2AMLogic/sg13g2-sram/sim/column/README.md

# sim/column

Nominal functional bench of the I/O column (`design/column/`): read of 0 and 1,
write of 0 and 1, at mos_tt, 1.20 V, 27 °C only. The corner grid, Monte Carlo,
access time and array-level margins are #26.

- `bench_read.cir`, `bench_write.cir`: two column copies each (real `bitcell`
  netlist, 127 unselected rows per bit line present, the half-selected cell of
  the unselected mux column present). Timelines are in the file headers.
- `column_post.py`: generates the `klt sim` requests, evaluates the
  measurements into per-case verdicts, builds the negative-control benches.
  `test_column_post.py` tests it without a simulator.
- `run_column.sh`: freshness check of the netlists, both benches, two negative
  controls (write-driver stacks at 0.15 µm; sense enable fired with the
  wordline), then `records/<UTC>/` (append-only).

Checks per case (limits are this bench's functional criteria, not spec values):
`OUT` resolves the stored value (|OUT−OUTB| > 1.0 V); bit-line differential at
the sense instant has the right sign; bit lines precharged (> 1.15 V) and
equalized (< 20 mV) before the wordline; selected and half-selected cells keep
their value; the unselected column's bit lines stay above 0.6 V. Write: flipped
at the end of the 1 ns pulse, flip time (from the 50 % point of the WL edge)
under 1 ns, value holds at 2.8 ns.

## Status

Latest record: `records/20261027T234939Z/` (nominal, mos_tt / 1.20 V / 27 C; batch
job `klt-sim-101d18689c47`, runner klt 0.8.0, ngspice 46). `all_pass` is **true**.
The benches now include only `design/column/column.spice`, which embeds the bitcell and
periphery subckts; before, each subckt was defined twice. Read and write verdicts match
the previous record `records/20261027T220739Z/` (same flip-time range, same detections).
The column has per-pair precharge enables (`PRE0_B`, `PRE1_B`); the benches hold the
unselected pair's enable low (precharged) through the wordline pulse.

- Read of 0 and of 1: the sense amp resolves the stored value, the bit-line
  differential has the right sign, precharge and equalize complete, both cells
  keep their value.
- Write of 0 and of 1: the cell flips 0.06-0.09 ns after the wordline midpoint
  (limit 1 ns) and the value holds at 2.8 ns.
- Unselected column: bit lines stay at or above 1.118 V (limit 0.6 V, unchanged).
- Negative controls: the 0.15 um write driver and the SAE-with-wordline read are
  both detected.

Earlier record `records/20261027T211740Z/` (shared `PRE_B`, `all_pass` false:
the floating unselected pair fell to about 0.07 V) is kept unchanged as evidence.
The write-driver sizing justification is in `design/column/README.md` (sweep below).

## Write-driver width sweep

`run_sizing.sh [width_um ...]` writes one write bench per driver-stack width
(default 0.15 0.3 0.5 1.0 2.0 3.0 um, mos_tt / 1.20 V / 27 C) and submits them as one
`klt sim --batch-set` (batch only, no local fallback, `--capacity-retries 4`). It leaves the
reports under `sizing/<UTC>/` (append-only); summarise with
`python3 -I column_post.py sizing <label> <width_um>=<report> ...`, which gives the flip
time per width and the smallest passing width; `run_sizing.sh` does this itself and writes
`summary.json`. **Run** on 2026-10-28 (`sizing/20261028T074902Z/`, six batch jobs, runner
klt 0.8.0): flip time at 0.15 / 0.3 / 0.5 / 1.0 / 2.0 / 3.0 µm is no flip / 0.96 (fails the
1 ns check) / 0.54 / 0.25 / 0.12 / 0.09 ns (worst of the two written values); smallest
passing width 0.5 µm. The per-width reports were fetched by re-attaching to the batch jobs
(`--attach`) because the first version of the script deleted its scratch dir; the script now
keeps them.

A klt batch run whose corner errors exits 4; `run_column.sh` accepts that only for
the two negative controls (a driver that never flips the cell leaves the flip
time without a value, which is the detection) and only if the report exists.
