2AMLogic/sg13g2-sram/spec/porting-plan.md

# Porting plan: `gf180-sram` to SG13G2

**Status**: Proposed, 2026-10-17 (not self-ratified)
**Origin read**: `2AMLogic/gf180-sram` @ `d0bacc0fceb6e9400e54e3efe15ec1630711faa9`
(local checkout `~/GitHub/gf180-sram`, `main` HEAD on 2026-10-17)

`gf180-sram` is master for the spec structure, margin definitions,
statistical treatment and harness. This table lists every item as
**inherited** (taken unchanged, with the origin file) or **re-derived**
(device-level, with the reason). Departures from the origin are decision
records in this directory.

## Inherited

| Item | Origin file @ `d0bacc0` | Here |
|---|---|---|
| Organization: fixed 256 × 32 (1 kB) first; generator is a stretch | `spec/sram.md` § Organization | `spec/sram.md` |
| Ports: 1RW target, 1RW1R stretch | `spec/sram.md` § Ports | `spec/sram.md` |
| Deliverables: GDS, LEF, Liberty generated by this repo's own flow | `spec/sram.md` § Deliverables | `spec/sram.md` |
| Block kind: `analog` (scoped to custom bitcell/array and PVT characterization) | `spec/block-kind-decision.md` | `spec/sram.md` |
| Margin definitions: read SNM, hold SNM, write margin; access time recorded per corner | `spec/sram.md` § Characterization | `spec/sram.md` |
| Pass rule: SNMs and write margin strictly positive at every corner | `spec/sram.md` § Signoff definition | `spec/sram.md` |
| Statistical treatment: the three margins are Monte Carlo rows, combined with (never replacing) the corner matrix; seed, sample count, deterministic negative control, `klt yield` report | `spec/statistical-treatment-decision.md` | `spec/sram.md` |
| Grading: Cpk, sigma-to-spec and the exact empirical-yield lower bound; no numeric `target_yield` | `spec/target-yield-decision.md` | `spec/sram.md` |
| Write margin measured against a fixed, stated pulse width; no independent macro timing target | `spec/write-pulse-width-decision.md` (rule only; the value is re-derived) | `spec/write-pulse-width-decision.md` |
| Corner count stated as arithmetic with the product written out | `spec/corner-count-correction.md` | `spec/sram.md` |
| Sim harness (corner sweep, MC campaign, SNM extraction) | `sim/lib/` (`run_corner_sweep.sh`, `run_mc_campaign.py`, `snm_extract.py`, `pdk_env.sh`) | by pinned reference, see #4; `mint_sim_envelope.py` and `render_signoff_table.py` not ported, see `spec/signoff-tooling-decision.md`; `env_provenance.py` not vendored, see `spec/env-provenance-departure-decision.md` |
| Append-only `sim/` evidence | `CLAUDE.md` | `CLAUDE.md` |

The harness is not vendored by this issue. The pinned-reference mechanism
(`reuse.lock.json`, `REUSE.md` in `2AMLogic/2am`) belongs to #4. Neither file
exists in this repo yet, so the harness row above names the origin paths only.

## Re-derived

| Item | Why it cannot be inherited | Where |
|---|---|---|
| Bitcell: topology and sizing | Different devices (`sg13_lv_nmos` / `sg13_lv_pmos`, 130 nm, 1.2 V) and a different answer to the first question | `spec/bitcell-decision.md` |
| Supply: 1.2 V ±10% (1.08 / 1.20 / 1.32 V) | Origin is 3.3 V; SG13G2 core devices are 1.2 V | `spec/sram.md` |
| Rail sharing (array vs periphery) | Shipped macros separate `VDD` from `VDDARRAY`; the origin has one rail | `spec/sram.md`, open |
| PVT corners: `mos_tt/ss/ff/sf/fs` × −40/25/125 °C × 3 supplies = 45 | Origin used `ff/tt/ss` only (27). SG13G2 ships skew corners | `spec/sram.md` |
| Write-pulse width value | Origin's 2 ns was a testbench window tied to a 180 nm, 3.3 V cell; the number does not transfer | `spec/write-pulse-width-decision.md` |
| Reference row (area, timing) | Different comparison part (`RM_IHPSG13_1P_256x32_c2_bm_bist`) | `spec/sram.md` |
| Deck acceptance | Different deck (klt SG13G2, newer) | `spec/sram.md` |
| PDK pin and OSDI model loading | Origin pinned `gf180mcuD`; SG13G2 compact models load through OSDI | #5, not this issue |

## Open questions from the issue

| Question | Status | Owner |
|---|---|---|
| Does klt's SG13G2 LVS extract a dense 6T array correctly at full size? | **Open, verify at first run.** No array exists yet; nothing is assumed. | bitcell and array layout issues; friction goes to `2AMLogic/klayout-tools` |
| Does the origin harness run unchanged on OSDI-loaded models? | **Open, verify at first run.** Likely divergences to watch: `.lib` section names (`mos_tt` etc. in `cornerMOSlv.lib`), OSDI module loading in `ngspice`, Monte Carlo parameter names. Any divergence gets recorded, not hidden. | #5 (PDK/OSDI pin and smoke sim), #4 (harness reuse) |
| Should the 1RW pin interface differ? | **No.** Answered in `spec/sram.md` § Ports: keep the origin's interface; the shipped macro's differs (bit mask, BIST, `A_DLY`) and is a comparison, not a template. | this issue |

## Checks run for this document

- Every origin path above exists at the pinned commit
  (`git -C ~/GitHub/gf180-sram cat-file -e d0bacc0:<path>`), run
  2026-10-17.
- `sim/lib/` filenames were read from the origin checkout's working tree at
  the same commit.
