2AMLogic/sg13g2-sram/WORK_PLAN.md

# Work Plan

Roadmap generated by the Guide triage agent from current GitHub label state.
Only the region between the markers is machine-generated.

<!-- guide:plan-body:start -->
## Operator Attention: Merge-Risk-Hold Pileup

Judge-approved PRs under a hold (`loom:blocked` or `loom:operator`) — only a human merge decision is missing.

_None._

## Very Important

`loom:very-important` (one counts per workspace); every stage takes these first.

- **#105**: layout: route decoder cell internals

## Important

`loom:important`; taken before unlabelled work.

- **#88**: Macro layout: route periphery, array-to-column-path and pins so the macro is extractable
- **#105**: layout: route decoder cell internals
- **#107**: layout: route global control fan-out and per-slice DL/DOUT
- **#108**: layout: connect macro pins, signals record, verify and README

## Ready

Human-approved issues ready for implementation (`loom:issue`).

_None._

## In Progress

Issues currently being built (`loom:building`).

- **#37**: Post-hoc two-key ratification review of spec/sram.md as merged in #7
- **#56**: Consolidate duplicated helpers across sim/*_post.py into one shared module
- **#69**: spec: confirm the 1 ns write-pulse window
- **#71**: spec: write-margin definition under-specified
- **#72**: spec: internal inconsistencies in sram.md text
- **#74**: spec: no area target, min-clock-pulse, power or retention rows
- **#105**: layout: route decoder cell internals
- **#126**: netlist: scalar WEN vs the origin's per-bit WEN[31:0]; Views row ratified by #79 assumes the per-bit interface

## PRs Awaiting Review

PRs waiting on Judge (`loom:review-requested`).

- **#77**: docs(spec): record two-key review outcome for sram.md
- **#78**: docs: make spec/sram.md internally consistent on corners, signoff, open items, typical point
- **#80**: docs: add decision record for area, min-clock-pulse, power and retention spec rows
- **#81**: docs(spec): pin the write-margin definition in a decision record

## Approved (Awaiting Merge)

PRs that passed review and are queued for Champion auto-merge (`loom:pr`).

_None._

## Proposed

Issues carrying `loom:curated`.

- **#30**: T1 item 4 (LVS clean): klt lvs of the full macro vs the item-1 netlist *(curated)*
- **#37**: Post-hoc two-key ratification review of spec/sram.md as merged in #7 *(curated)*
- **#68**: spec: margins row has no Monte Carlo evidence *(curated)*
- **#69**: spec: confirm the 1 ns write-pulse window *(curated)*
- **#71**: spec: write-margin definition under-specified *(curated)*
- **#72**: spec: internal inconsistencies in sram.md text *(curated)*
- **#74**: spec: no area target, min-clock-pulse, power or retention rows *(curated)*
- **#88**: Macro layout: route periphery, array-to-column-path and pins so the macro is extractable *(curated)*
- **#105**: layout: route decoder cell internals *(curated)*
- **#107**: layout: route global control fan-out and per-slice DL/DOUT *(curated)*
- **#126**: netlist: scalar WEN vs the origin's per-bit WEN[31:0]; Views row ratified by #79 assumes the per-bit interface *(curated)*

## Proposed (Architect / Hermit)

- **#56**: Consolidate duplicated helpers across sim/*_post.py into one shared module *(hermit)*
- **#117**: Remove superseded macro-record scripts generate-macro-routed.sh and generate-macro-rails.sh *(hermit)*

## Epics

_None._

## Backlog Balance

| Bucket | Count |
|---|---|
| Operator merge-risk holds | 0 |
| Very important | 1 |
| Important | 4 |
| Ready (`loom:issue`) | 0 |
| In Progress (`loom:building`) | 8 |
| PRs awaiting review | 4 |
| Approved PRs awaiting merge | 0 |
| Curated | 11 |
| Architect / Hermit proposals | 2 |
| Active epics | 0 |
<!-- guide:plan-body:end -->
