2AMLogic/sg13g2-sram/ratification/ee-key/MANIFEST.md

# MANIFEST — ee-key

Adapted 2026-10-27 from `2AMLogic/gf180-gate-driver` `ratification/ee-key/`. The rubric gains an SRAM-macro section; the sibling-precedent list in `SKILL.md` Step 3 names the SRAM siblings. Nothing else differs from the template.

## Skill files

- `SKILL.md`
- `rubric.md`

Installed at `ratification/ee-key/`.
