2AMLogic/sg13g2-sram/ratification/market-key/MANIFEST.md

# MANIFEST — market-key

Adapted 2026-10-27 from `2AMLogic/gf180-gate-driver` `ratification/market-key/`. The gate-driver comp data is replaced by `comps/sram.md`; `comp-table-format.md` loses one repo-specific numbering example. `SKILL.md` and `rubric.md` are unchanged from the template.

## Skill files

- `SKILL.md`
- `comp-table-format.md`
- `rubric.md`

## Comp data

- `comps/sram.md`
