2AMLogic/sg13g2-sram/ratification/ee-key/rubric.md

# Verdict rubric

Three tokens, applied per row (`SKILL.md` Step 4) and rolled up to one
overall `approve`/`request-changes` verdict (`SKILL.md`'s "Output format").

Deliberately self-contained: nothing below names, numbers, or references
this repo's own internal fleet-operations detail — only device physics, the target
repo's own cited evidence, and `klayout-tools`' public
`docs/design-evidence-tiers.md`.

## `sound`

The row's claim is independently re-derivable from cited design sources
(schematic, netlist, sizing table) and/or backed by `sim/` evidence that
passes the relevant `design-evidence-tiers.md` T1 items for that row
(provenance-fresh, corner coverage matching the claim, Monte Carlo present
if the row is statistical). A row whose value is a **mechanical consequence**
of an already-ratified row plus the merged design's own structure — with no
new measurement needed — is also `sound`, provided the derivation is
actually checked against the source rather than merely asserted.

## `insufficient-evidence`

The row's value is not physically implausible, but the evidence backing it
falls short of what `design-evidence-tiers.md`'s T1 checklist requires for
the claim being made — an "informal, uncommitted" sanity check the design
doc itself disclaims as non-evidentiary, a single-corner/single-temperature
check standing in for a PVT claim, a plumbing-only `sim/` record (the DUT
never completed simulation) standing in for a design measurement, or a
statistical row backed only by a deterministic corner sweep. This is not a
verdict that the value is wrong — it is a statement that this key cannot
certify it as `sound` on the evidence actually on record, and the row should
stay unratified (or be flagged) until the gap closes.

## `unsound`

The row's claim contradicts what the cited design source, PDK physics, or
existing `sim/` evidence actually shows — a re-derivation that does not
match the PR's stated conclusion, a claim that ignores a device limit or
corner-dependent effect the block's own topology is known to be sensitive
to, or a row ratified on the back of evidence that itself failed (see the
relax-after-measured-FAIL check, `SKILL.md` Step 5) without an independent
physical justification for why the weaker value still holds. Absence of any
evidence at all for a claim with no plausible mechanical derivation is
`unsound` by default, the same way the market key's own rubric treats an
uncited value as `uncompetitive` by default rather than extending it the
benefit of the doubt.

## SRAM-macro rows: what `sound` has to cover

Applied on top of the three tokens above when the spec is an SRAM macro:

- **Bitcell margin rows (read SNM, hold SNM, write margin)** are mismatch-
  driven. `sound` needs the corner matrix **and** Monte Carlo evidence
  (recorded seed, sample count, deterministic negative control); a corner
  sweep alone is `insufficient-evidence`, per the statistical-row clause
  above. Skew corners matter because read stability and write margin move in
  opposite directions across the skew.
- **Supply and corner rows** must match the models actually loaded for the
  device class (core-voltage devices only, the corner file the rows cite).
- **Access time and write completion** are recorded values, not pass
  thresholds, unless the spec ratifies a number; a row that states a
  threshold with no measurement is `unsound` by default.
- **Array/periphery rows** (organization, ports, pin interface) are
  mechanical consequences of the cited organization where they are
  derivations; check the arithmetic against the cited source.
- **Open items the spec itself lists** (for example rail sharing) are not
  rows to be ratified; confirm each is marked open with an owner, and that no
  row silently depends on its outcome.
- **Deck acceptance** statements (DRC/LVS "clean" definitions) are checked
  for what they claim: a definition that has not yet been run is fine
  if it says so, and is `unsound` if it presents an unrun check as done.

## The EE-key / market-key jurisdiction boundary

This key reviews **every** row a ratification PR proposes for technical
soundness — unlike the market key, there is no row-classification split
into "in scope"/"out of scope" here, because every spec row makes a physical
engineering claim whether or not a buyer could observe it externally. What
this key does **not** do is rule on whether a technically sound value is
*competitive* — a row can be `sound` (physically well-derived, adequately
evidenced) and still be weak against the market, or `unsound` and still
happen to beat every public comp; the two questions are independent by
design.
Scoring competitiveness,
favorably or unfavorably, is itself a rubric violation for this key — it
lets the EE key exercise judgment over ground the two-key design reserves
for the market key, defeating the incentive-separation the mechanism exists
to protect.
