2AMLogic/sg13g2-sram/design/column/column.spice

** sch_path: design/column/column.sch

* one I/O column, mux 2: two bit-line pairs of 128 cells (7 row + 1 column address bits).


* WL = the selected row (both pairs), WLU = the other 127 rows (shared net, held low).


* XU cells of a pair share one Q/QB node pair UQ/UQB: 127 identical cells, same state.

.subckt column PRE0_B PRE1_B SEL0 SEL0B SEL1 SEL1B SAE WE DIN WL WLU DOUT DOUTB VDD VSS
*.ipin PRE0_B
*.ipin PRE1_B
*.ipin SEL0
*.ipin SEL0B
*.ipin SEL1
*.ipin SEL1B
*.ipin SAE
*.ipin WE
*.ipin DIN
*.ipin WL
*.ipin WLU
*.iopin DOUT
*.iopin DOUTB
*.iopin VDD
*.iopin VSS
XC0 BL0 BLB0 WL VDD VSS Q0 QB0 bitcell
XC1 BL1 BLB1 WL VDD VSS Q1 QB1 bitcell
XU0[126] BL0 BLB0 WLU VDD VSS UQ0 UQB0 bitcell
XU0[125] BL0 BLB0 WLU VDD VSS UQ0 UQB0 bitcell
XU0[124] BL0 BLB0 WLU VDD VSS UQ0 UQB0 bitcell
XU0[123] BL0 BLB0 WLU VDD VSS UQ0 UQB0 bitcell
XU0[122] BL0 BLB0 WLU VDD VSS UQ0 UQB0 bitcell
XU0[121] BL0 BLB0 WLU VDD VSS UQ0 UQB0 bitcell
XU0[120] BL0 BLB0 WLU VDD VSS UQ0 UQB0 bitcell
XU0[119] BL0 BLB0 WLU VDD VSS UQ0 UQB0 bitcell
XU0[118] BL0 BLB0 WLU VDD VSS UQ0 UQB0 bitcell
XU0[117] BL0 BLB0 WLU VDD VSS UQ0 UQB0 bitcell
XU0[116] BL0 BLB0 WLU VDD VSS UQ0 UQB0 bitcell
XU0[115] BL0 BLB0 WLU VDD VSS UQ0 UQB0 bitcell
XU0[114] BL0 BLB0 WLU VDD VSS UQ0 UQB0 bitcell
XU0[113] BL0 BLB0 WLU VDD VSS UQ0 UQB0 bitcell
XU0[112] BL0 BLB0 WLU VDD VSS UQ0 UQB0 bitcell
XU0[111] BL0 BLB0 WLU VDD VSS UQ0 UQB0 bitcell
XU0[110] BL0 BLB0 WLU VDD VSS UQ0 UQB0 bitcell
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
XU1[15] BL1 BLB1 WLU VDD VSS UQ1 UQB1 bitcell
XU1[14] BL1 BLB1 WLU VDD VSS UQ1 UQB1 bitcell
XU1[13] BL1 BLB1 WLU VDD VSS UQ1 UQB1 bitcell
XU1[12] BL1 BLB1 WLU VDD VSS UQ1 UQB1 bitcell
XU1[11] BL1 BLB1 WLU VDD VSS UQ1 UQB1 bitcell
XU1[10] BL1 BLB1 WLU VDD VSS UQ1 UQB1 bitcell
XU1[9] BL1 BLB1 WLU VDD VSS UQ1 UQB1 bitcell
XU1[8] BL1 BLB1 WLU VDD VSS UQ1 UQB1 bitcell
XU1[7] BL1 BLB1 WLU VDD VSS UQ1 UQB1 bitcell
XU1[6] BL1 BLB1 WLU VDD VSS UQ1 UQB1 bitcell
XU1[5] BL1 BLB1 WLU VDD VSS UQ1 UQB1 bitcell
XU1[4] BL1 BLB1 WLU VDD VSS UQ1 UQB1 bitcell
XU1[3] BL1 BLB1 WLU VDD VSS UQ1 UQB1 bitcell
XU1[2] BL1 BLB1 WLU VDD VSS UQ1 UQB1 bitcell
XU1[1] BL1 BLB1 WLU VDD VSS UQ1 UQB1 bitcell
XU1[0] BL1 BLB1 WLU VDD VSS UQ1 UQB1 bitcell
XPC0 PRE0_B BL0 BLB0 VDD VSS precharge
XPC1 PRE1_B BL1 BLB1 VDD VSS precharge
XMUX SEL0 SEL0B SEL1 SEL1B BL0 BLB0 BL1 BLB1 BLM BLBM VDD VSS column_mux
XSA SAE BLM BLBM DOUT DOUTB VDD VSS sense_amp
XWD WE DIN BLM BLBM VDD VSS write_driver
.ends

* expanding   symbol:  ../bitcell/bitcell.sym # of pins=7
** sym_path: design/bitcell/bitcell.sym
** sch_path: design/bitcell/bitcell.sch
.subckt bitcell BL BLB WL VDD VSS Q QB
*.iopin BL
*.iopin BLB
*.ipin WL
*.iopin VDD
*.iopin VSS
*.iopin Q
*.iopin QB
XMP0 Q QB VDD VDD sg13_lv_pmos w=0.15u l=0.13u ng=1 m=1
XMN0 Q QB VSS VSS sg13_lv_nmos w=0.30u l=0.13u ng=1 m=1
XMP1 QB Q VDD VDD sg13_lv_pmos w=0.15u l=0.13u ng=1 m=1
XMN1 QB Q VSS VSS sg13_lv_nmos w=0.30u l=0.13u ng=1 m=1
XMN2 BL WL Q VSS sg13_lv_nmos w=0.30u l=0.13u ng=1 m=1
XMN3 BLB WL QB VSS sg13_lv_nmos w=0.30u l=0.13u ng=1 m=1
**** begin user architecture code

* 6T SRAM bitcell, reference sizing from spec/bitcell-decision.md evidence 1

**** end user architecture code
.ends


* expanding   symbol:  precharge.sym # of pins=5
** sym_path: design/column/precharge.sym
** sch_path: design/column/precharge.sch
.subckt precharge PRE_B BL BLB VDD VSS
*.ipin PRE_B
*.iopin BL
*.iopin BLB
*.iopin VDD
*.iopin VSS
XMP0 BL PRE_B VDD VDD sg13_lv_pmos w=1.0u l=0.13u ng=1 m=1
XMP1 BLB PRE_B VDD VDD sg13_lv_pmos w=1.0u l=0.13u ng=1 m=1
XMP2 BL PRE_B BLB VDD sg13_lv_pmos w=1.0u l=0.13u ng=1 m=1
**** begin user architecture code

* bit-line precharge to VDD and equalize, active-low PRE_B

**** end user architecture code
.ends


* expanding   symbol:  column_mux.sym # of pins=12
** sym_path: design/column/column_mux.sym
** sch_path: design/column/column_mux.sch
.subckt column_mux SEL0 SEL0B SEL1 SEL1B BL0 BLB0 BL1 BLB1 BLM BLBM VDD VSS
*.ipin SEL0
*.ipin SEL0B
*.ipin SEL1
*.ipin SEL1B
*.iopin BL0
*.iopin BLB0
*.iopin BL1
*.iopin BLB1
*.iopin BLM
*.iopin BLBM
*.iopin VDD
*.iopin VSS
XMN0T BL0 SEL0 BLM VSS sg13_lv_nmos w=2.0u l=0.13u ng=1 m=1
XMP0T BL0 SEL0B BLM VDD sg13_lv_pmos w=2.0u l=0.13u ng=1 m=1
XMN0B BLB0 SEL0 BLBM VSS sg13_lv_nmos w=2.0u l=0.13u ng=1 m=1
XMP0B BLB0 SEL0B BLBM VDD sg13_lv_pmos w=2.0u l=0.13u ng=1 m=1
XMN1T BL1 SEL1 BLM VSS sg13_lv_nmos w=2.0u l=0.13u ng=1 m=1
XMP1T BL1 SEL1B BLM VDD sg13_lv_pmos w=2.0u l=0.13u ng=1 m=1
XMN1B BLB1 SEL1 BLBM VSS sg13_lv_nmos w=2.0u l=0.13u ng=1 m=1
XMP1B BLB1 SEL1B BLBM VDD sg13_lv_pmos w=2.0u l=0.13u ng=1 m=1
**** begin user architecture code

* 2:1 column mux: NMOS+PMOS transmission gates, SELn high / SELnB low selects column n

**** end user architecture code
.ends


* expanding   symbol:  sense_amp.sym # of pins=7
** sym_path: design/column/sense_amp.sym
** sch_path: design/column/sense_amp.sch
.subckt sense_amp SAE BLM BLBM OUT OUTB VDD VSS
*.ipin SAE
*.iopin BLM
*.iopin BLBM
*.iopin OUT
*.iopin OUTB
*.iopin VDD
*.iopin VSS
XMPI0 OUT SAE BLM VDD sg13_lv_pmos w=2.0u l=0.13u ng=1 m=1
XMPI1 OUTB SAE BLBM VDD sg13_lv_pmos w=2.0u l=0.13u ng=1 m=1
XMPL0 OUT OUTB VDD VDD sg13_lv_pmos w=1.0u l=0.13u ng=1 m=1
XMPL1 OUTB OUT VDD VDD sg13_lv_pmos w=1.0u l=0.13u ng=1 m=1
XMNL0 OUT OUTB TAIL VSS sg13_lv_nmos w=1.0u l=0.13u ng=1 m=1
XMNL1 OUTB OUT TAIL VSS sg13_lv_nmos w=1.0u l=0.13u ng=1 m=1
XMNT TAIL SAE VSS VSS sg13_lv_nmos w=2.0u l=0.13u ng=1 m=1
**** begin user architecture code

* latch SA: SAE low = isolation PMOS pass bit lines to OUT/OUTB, SAE high = latch

**** end user architecture code
.ends


* expanding   symbol:  write_driver.sym # of pins=6
** sym_path: design/column/write_driver.sym
** sch_path: design/column/write_driver.sch
.subckt write_driver WE DIN BLM BLBM VDD VSS
*.ipin WE
*.ipin DIN
*.iopin BLM
*.iopin BLBM
*.iopin VDD
*.iopin VSS
XMPD DINB DIN VDD VDD sg13_lv_pmos w=0.5u l=0.13u ng=1 m=1
XMND DINB DIN VSS VSS sg13_lv_nmos w=0.5u l=0.13u ng=1 m=1
XMNA0 BLM DINB WA VSS sg13_lv_nmos w=3.0u l=0.13u ng=1 m=1
XMNA1 WA WE VSS VSS sg13_lv_nmos w=3.0u l=0.13u ng=1 m=1
XMNB0 BLBM DIN WB VSS sg13_lv_nmos w=3.0u l=0.13u ng=1 m=1
XMNB1 WB WE VSS VSS sg13_lv_nmos w=3.0u l=0.13u ng=1 m=1
**** begin user architecture code

* write driver: WE and DIN pull BLBM low, WE and DINB pull BLM low (cell Q takes DIN)

**** end user architecture code
.ends
