2AMLogic/sg13g2-sram/design/decoder/row_decoder.spice

** sch_path: design/decoder/row_decoder.sch

* 7-bit row decoder: A[2:0] -> X (8), A[6:3] -> Y (16), WL[8*j+k] = X[k] & Y[j] & WLEN

.subckt row_decoder A[6] A[5] A[4] A[3] A[2] A[1] A[0] WLEN WL[127] WL[126] WL[125] WL[124] WL[123] WL[122] WL[121] WL[120]
+ WL[119] WL[118] WL[117] WL[116] WL[115] WL[114] WL[113] WL[112] WL[111] WL[110] WL[109] WL[108] WL[107] WL[106] WL[105] WL[104] WL[103]
+ WL[102] WL[101] WL[100] WL[99] WL[98] WL[97] WL[96] WL[95] WL[94] WL[93] WL[92] WL[91] WL[90] WL[89] WL[88] WL[87] WL[86] WL[85] WL[84]
+ WL[83] WL[82] WL[81] WL[80] WL[79] WL[78] WL[77] WL[76] WL[75] WL[74] WL[73] WL[72] WL[71] WL[70] WL[69] WL[68] WL[67] WL[66] WL[65]
+ WL[64] WL[63] WL[62] WL[61] WL[60] WL[59] WL[58] WL[57] WL[56] WL[55] WL[54] WL[53] WL[52] WL[51] WL[50] WL[49] WL[48] WL[47] WL[46]
+ WL[45] WL[44] WL[43] WL[42] WL[41] WL[40] WL[39] WL[38] WL[37] WL[36] WL[35] WL[34] WL[33] WL[32] WL[31] WL[30] WL[29] WL[28] WL[27]
+ WL[26] WL[25] WL[24] WL[23] WL[22] WL[21] WL[20] WL[19] WL[18] WL[17] WL[16] WL[15] WL[14] WL[13] WL[12] WL[11] WL[10] WL[9] WL[8] WL[7]
+ WL[6] WL[5] WL[4] WL[3] WL[2] WL[1] WL[0] VDD VSS
*.ipin A[6]
*.ipin A[5]
*.ipin A[4]
*.ipin A[3]
*.ipin A[2]
*.ipin A[1]
*.ipin A[0]
*.ipin WLEN
*.opin WL[127]
*.opin WL[126]
*.opin WL[125]
*.opin WL[124]
*.opin WL[123]
*.opin WL[122]
*.opin WL[121]
*.opin WL[120]
*.opin WL[119]
*.opin WL[118]
*.opin WL[117]
*.opin WL[116]
*.opin WL[115]
*.opin WL[114]
*.opin WL[113]
*.opin WL[112]
*.opin WL[111]
*.opin WL[110]
*.opin WL[109]
*.opin WL[108]
*.opin WL[107]
*.opin WL[106]
*.opin WL[105]
*.opin WL[104]
*.opin WL[103]
*.opin WL[102]
*.opin WL[101]
*.opin WL[100]
*.opin WL[99]
*.opin WL[98]
*.opin WL[97]
*.opin WL[96]
*.opin WL[95]
*.opin WL[94]
*.opin WL[93]
*.opin WL[92]
*.opin WL[91]
*.opin WL[90]
*.opin WL[89]
*.opin WL[88]
*.opin WL[87]
*.opin WL[86]
*.opin WL[85]
*.opin WL[84]
*.opin WL[83]
*.opin WL[82]
*.opin WL[81]
*.opin WL[80]
*.opin WL[79]
*.opin WL[78]
*.opin WL[77]
*.opin WL[76]
*.opin WL[75]
*.opin WL[74]
*.opin WL[73]
*.opin WL[72]
*.opin WL[71]
*.opin WL[70]
*.opin WL[69]
*.opin WL[68]
*.opin WL[67]
*.opin WL[66]
*.opin WL[65]
*.opin WL[64]
*.opin WL[63]
*.opin WL[62]
*.opin WL[61]
*.opin WL[60]
*.opin WL[59]
*.opin WL[58]
*.opin WL[57]
*.opin WL[56]
*.opin WL[55]
*.opin WL[54]
*.opin WL[53]
*.opin WL[52]
*.opin WL[51]
*.opin WL[50]
*.opin WL[49]
*.opin WL[48]
*.opin WL[47]
*.opin WL[46]
*.opin WL[45]
*.opin WL[44]
*.opin WL[43]
*.opin WL[42]
*.opin WL[41]
*.opin WL[40]
*.opin WL[39]
*.opin WL[38]
*.opin WL[37]
*.opin WL[36]
*.opin WL[35]
*.opin WL[34]
*.opin WL[33]
*.opin WL[32]
*.opin WL[31]
*.opin WL[30]
*.opin WL[29]
*.opin WL[28]
*.opin WL[27]
*.opin WL[26]
*.opin WL[25]
*.opin WL[24]
*.opin WL[23]
*.opin WL[22]
*.opin WL[21]
*.opin WL[20]
*.opin WL[19]
*.opin WL[18]
*.opin WL[17]
*.opin WL[16]
*.opin WL[15]
*.opin WL[14]
*.opin WL[13]
*.opin WL[12]
*.opin WL[11]
*.opin WL[10]
*.opin WL[9]
*.opin WL[8]
*.opin WL[7]
*.opin WL[6]
*.opin WL[5]
*.opin WL[4]
*.opin WL[3]
*.opin WL[2]
*.opin WL[1]
*.opin WL[0]
*.iopin VDD
*.iopin VSS
XP3 A[2] A[1] A[0] X[7] X[6] X[5] X[4] X[3] X[2] X[1] X[0] VDD VSS predec3
XP4 A[6] A[5] A[4] A[3] Y[15] Y[14] Y[13] Y[12] Y[11] Y[10] Y[9] Y[8] Y[7] Y[6] Y[5] Y[4] Y[3] Y[2] Y[1] Y[0] VDD VSS predec4
XWD X[7] X[6] X[5] X[4] X[3] X[2] X[1] X[0] Y[15] Y[14] Y[13] Y[12] Y[11] Y[10] Y[9] Y[8] Y[7] Y[6] Y[5] Y[4] Y[3] Y[2] Y[1] Y[0]
+ WLEN WL[127] WL[126] WL[125] WL[124] WL[123] WL[122] WL[121] WL[120] WL[119] WL[118] WL[117] WL[116] WL[115] WL[114] WL[113] WL[112]
+ WL[111] WL[110] WL[109] WL[108] WL[107] WL[106] WL[105] WL[104] WL[103] WL[102] WL[101] WL[100] WL[99] WL[98] WL[97] WL[96] WL[95] WL[94]
+ WL[93] WL[92] WL[91] WL[90] WL[89] WL[88] WL[87] WL[86] WL[85] WL[84] WL[83] WL[82] WL[81] WL[80] WL[79] WL[78] WL[77] WL[76] WL[75]
+ WL[74] WL[73] WL[72] WL[71] WL[70] WL[69] WL[68] WL[67] WL[66] WL[65] WL[64] WL[63] WL[62] WL[61] WL[60] WL[59] WL[58] WL[57] WL[56]
+ WL[55] WL[54] WL[53] WL[52] WL[51] WL[50] WL[49] WL[48] WL[47] WL[46] WL[45] WL[44] WL[43] WL[42] WL[41] WL[40] WL[39] WL[38] WL[37]
+ WL[36] WL[35] WL[34] WL[33] WL[32] WL[31] WL[30] WL[29] WL[28] WL[27] WL[26] WL[25] WL[24] WL[23] WL[22] WL[21] WL[20] WL[19] WL[18]
+ WL[17] WL[16] WL[15] WL[14] WL[13] WL[12] WL[11] WL[10] WL[9] WL[8] WL[7] WL[6] WL[5] WL[4] WL[3] WL[2] WL[1] WL[0] VDD VSS wl_drivers
.ends

* expanding   symbol:  decoder/predec3.sym # of pins=13
** sym_path: design/decoder/predec3.sym
** sch_path: design/decoder/predec3.sch
.subckt predec3 A[2] A[1] A[0] X[7] X[6] X[5] X[4] X[3] X[2] X[1] X[0] VDD VSS
*.ipin A[2]
*.ipin A[1]
*.ipin A[0]
*.opin X[7]
*.opin X[6]
*.opin X[5]
*.opin X[4]
*.opin X[3]
*.opin X[2]
*.opin X[1]
*.opin X[0]
*.iopin VDD
*.iopin VSS
XI0 A[0] A0B VDD VSS inv
XI1 A[1] A1B VDD VSS inv
XI2 A[2] A2B VDD VSS inv
XN0 A0B A1B A2B N0 VDD VSS nand3
XO0 N0 X[0] VDD VSS inv
XN1 A[0] A1B A2B N1 VDD VSS nand3
XO1 N1 X[1] VDD VSS inv
XN2 A0B A[1] A2B N2 VDD VSS nand3
XO2 N2 X[2] VDD VSS inv
XN3 A[0] A[1] A2B N3 VDD VSS nand3
XO3 N3 X[3] VDD VSS inv
XN4 A0B A1B A[2] N4 VDD VSS nand3
XO4 N4 X[4] VDD VSS inv
XN5 A[0] A1B A[2] N5 VDD VSS nand3
XO5 N5 X[5] VDD VSS inv
XN6 A0B A[1] A[2] N6 VDD VSS nand3
XO6 N6 X[6] VDD VSS inv
XN7 A[0] A[1] A[2] N7 VDD VSS nand3
XO7 N7 X[7] VDD VSS inv
**** begin user architecture code

* 3-to-8 predecoder, active-high one-hot X[k], k = A[2:0]

**** end user architecture code
.ends


* expanding   symbol:  decoder/predec4.sym # of pins=22
** sym_path: design/decoder/predec4.sym
** sch_path: design/decoder/predec4.sch
.subckt predec4 A[3] A[2] A[1] A[0] Y[15] Y[14] Y[13] Y[12] Y[11] Y[10] Y[9] Y[8] Y[7] Y[6] Y[5] Y[4] Y[3] Y[2] Y[1] Y[0] VDD VSS
*.ipin A[3]
*.ipin A[2]
*.ipin A[1]
*.ipin A[0]
*.opin Y[15]
*.opin Y[14]
*.opin Y[13]
*.opin Y[12]
*.opin Y[11]
*.opin Y[10]
*.opin Y[9]
*.opin Y[8]
*.opin Y[7]
*.opin Y[6]
*.opin Y[5]
*.opin Y[4]
*.opin Y[3]
*.opin Y[2]
*.opin Y[1]
*.opin Y[0]
*.iopin VDD
*.iopin VSS
XI0 A[0] A0B VDD VSS inv
XI1 A[1] A1B VDD VSS inv
XI2 A[2] A2B VDD VSS inv
XI3 A[3] A3B VDD VSS inv
XN0 A0B A1B A2B A3B N0 VDD VSS nand4
XO0 N0 Y[0] VDD VSS inv
XN1 A[0] A1B A2B A3B N1 VDD VSS nand4
XO1 N1 Y[1] VDD VSS inv
XN2 A0B A[1] A2B A3B N2 VDD VSS nand4
XO2 N2 Y[2] VDD VSS inv
XN3 A[0] A[1] A2B A3B N3 VDD VSS nand4
XO3 N3 Y[3] VDD VSS inv
XN4 A0B A1B A[2] A3B N4 VDD VSS nand4
XO4 N4 Y[4] VDD VSS inv
XN5 A[0] A1B A[2] A3B N5 VDD VSS nand4
XO5 N5 Y[5] VDD VSS inv
XN6 A0B A[1] A[2] A3B N6 VDD VSS nand4
XO6 N6 Y[6] VDD VSS inv
XN7 A[0] A[1] A[2] A3B N7 VDD VSS nand4
XO7 N7 Y[7] VDD VSS inv
XN8 A0B A1B A2B A[3] N8 VDD VSS nand4
XO8 N8 Y[8] VDD VSS inv
XN9 A[0] A1B A2B A[3] N9 VDD VSS nand4
XO9 N9 Y[9] VDD VSS inv
XN10 A0B A[1] A2B A[3] N10 VDD VSS nand4
XO10 N10 Y[10] VDD VSS inv
XN11 A[0] A[1] A2B A[3] N11 VDD VSS nand4
XO11 N11 Y[11] VDD VSS inv
XN12 A0B A1B A[2] A[3] N12 VDD VSS nand4
XO12 N12 Y[12] VDD VSS inv
XN13 A[0] A1B A[2] A[3] N13 VDD VSS nand4
XO13 N13 Y[13] VDD VSS inv
XN14 A0B A[1] A[2] A[3] N14 VDD VSS nand4
XO14 N14 Y[14] VDD VSS inv
XN15 A[0] A[1] A[2] A[3] N15 VDD VSS nand4
XO15 N15 Y[15] VDD VSS inv
**** begin user architecture code

* 4-to-16 predecoder, active-high one-hot Y[j], j = A[3:0]

**** end user architecture code
.ends


* expanding   symbol:  decoder/wl_drivers.sym # of pins=155
** sym_path: design/decoder/wl_drivers.sym
** sch_path: design/decoder/wl_drivers.sch
.subckt wl_drivers X[7] X[6] X[5] X[4] X[3] X[2] X[1] X[0] Y[15] Y[14] Y[13] Y[12] Y[11] Y[10] Y[9] Y[8] Y[7] Y[6] Y[5] Y[4] Y[3]
+ Y[2] Y[1] Y[0] WLEN WL[127] WL[126] WL[125] WL[124] WL[123] WL[122] WL[121] WL[120] WL[119] WL[118] WL[117] WL[116] WL[115] WL[114]
+ WL[113] WL[112] WL[111] WL[110] WL[109] WL[108] WL[107] WL[106] WL[105] WL[104] WL[103] WL[102] WL[101] WL[100] WL[99] WL[98] WL[97]
+ WL[96] WL[95] WL[94] WL[93] WL[92] WL[91] WL[90] WL[89] WL[88] WL[87] WL[86] WL[85] WL[84] WL[83] WL[82] WL[81] WL[80] WL[79] WL[78]
+ WL[77] WL[76] WL[75] WL[74] WL[73] WL[72] WL[71] WL[70] WL[69] WL[68] WL[67] WL[66] WL[65] WL[64] WL[63] WL[62] WL[61] WL[60] WL[59]
+ WL[58] WL[57] WL[56] WL[55] WL[54] WL[53] WL[52] WL[51] WL[50] WL[49] WL[48] WL[47] WL[46] WL[45] WL[44] WL[43] WL[42] WL[41] WL[40]
+ WL[39] WL[38] WL[37] WL[36] WL[35] WL[34] WL[33] WL[32] WL[31] WL[30] WL[29] WL[28] WL[27] WL[26] WL[25] WL[24] WL[23] WL[22] WL[21]
+ WL[20] WL[19] WL[18] WL[17] WL[16] WL[15] WL[14] WL[13] WL[12] WL[11] WL[10] WL[9] WL[8] WL[7] WL[6] WL[5] WL[4] WL[3] WL[2] WL[1] WL[0]
+ VDD VSS
*.ipin X[7]
*.ipin X[6]
*.ipin X[5]
*.ipin X[4]
*.ipin X[3]
*.ipin X[2]
*.ipin X[1]
*.ipin X[0]
*.ipin Y[15]
*.ipin Y[14]
*.ipin Y[13]
*.ipin Y[12]
*.ipin Y[11]
*.ipin Y[10]
*.ipin Y[9]
*.ipin Y[8]
*.ipin Y[7]
*.ipin Y[6]
*.ipin Y[5]
*.ipin Y[4]
*.ipin Y[3]
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
XD[17] X[1] Y[2] WLEN WL[17] VDD VSS wl_driver
XD[16] X[0] Y[2] WLEN WL[16] VDD VSS wl_driver
XD[15] X[7] Y[1] WLEN WL[15] VDD VSS wl_driver
XD[14] X[6] Y[1] WLEN WL[14] VDD VSS wl_driver
XD[13] X[5] Y[1] WLEN WL[13] VDD VSS wl_driver
XD[12] X[4] Y[1] WLEN WL[12] VDD VSS wl_driver
XD[11] X[3] Y[1] WLEN WL[11] VDD VSS wl_driver
XD[10] X[2] Y[1] WLEN WL[10] VDD VSS wl_driver
XD[9] X[1] Y[1] WLEN WL[9] VDD VSS wl_driver
XD[8] X[0] Y[1] WLEN WL[8] VDD VSS wl_driver
XD[7] X[7] Y[0] WLEN WL[7] VDD VSS wl_driver
XD[6] X[6] Y[0] WLEN WL[6] VDD VSS wl_driver
XD[5] X[5] Y[0] WLEN WL[5] VDD VSS wl_driver
XD[4] X[4] Y[0] WLEN WL[4] VDD VSS wl_driver
XD[3] X[3] Y[0] WLEN WL[3] VDD VSS wl_driver
XD[2] X[2] Y[0] WLEN WL[2] VDD VSS wl_driver
XD[1] X[1] Y[0] WLEN WL[1] VDD VSS wl_driver
XD[0] X[0] Y[0] WLEN WL[0] VDD VSS wl_driver
**** begin user architecture code

* 128 wordline drivers; row r = 8*j + k is driven by X[k] and Y[j]

**** end user architecture code
.ends


* expanding   symbol:  gates/inv.sym # of pins=4
** sym_path: design/gates/inv.sym
** sch_path: design/gates/inv.sch
.subckt inv A Y VDD VSS
*.ipin A
*.opin Y
*.iopin VDD
*.iopin VSS
XMP Y A VDD VDD sg13_lv_pmos w=1.0u l=0.13u ng=1 m=1
XMN Y A VSS VSS sg13_lv_nmos w=0.5u l=0.13u ng=1 m=1
**** begin user architecture code

* inverter, N 0.5 um / P 1.0 um

**** end user architecture code
.ends


* expanding   symbol:  gates/nand3.sym # of pins=6
** sym_path: design/gates/nand3.sym
** sch_path: design/gates/nand3.sch
.subckt nand3 A B C Y VDD VSS
*.ipin A
*.ipin B
*.ipin C
*.opin Y
*.iopin VDD
*.iopin VSS
XMP0 Y A VDD VDD sg13_lv_pmos w=1.0u l=0.13u ng=1 m=1
XMP1 Y B VDD VDD sg13_lv_pmos w=1.0u l=0.13u ng=1 m=1
XMP2 Y C VDD VDD sg13_lv_pmos w=1.0u l=0.13u ng=1 m=1
XMN0 Y A N1 VSS sg13_lv_nmos w=1.5u l=0.13u ng=1 m=1
XMN1 N1 B N2 VSS sg13_lv_nmos w=1.5u l=0.13u ng=1 m=1
XMN2 N2 C VSS VSS sg13_lv_nmos w=1.5u l=0.13u ng=1 m=1
**** begin user architecture code

* 3-input NAND, N 1.5 um stack / P 1.0 um

**** end user architecture code
.ends


* expanding   symbol:  gates/nand4.sym # of pins=7
** sym_path: design/gates/nand4.sym
** sch_path: design/gates/nand4.sch
.subckt nand4 A B C D Y VDD VSS
*.ipin A
*.ipin B
*.ipin C
*.ipin D
*.opin Y
*.iopin VDD
*.iopin VSS
XMP0 Y A VDD VDD sg13_lv_pmos w=1.0u l=0.13u ng=1 m=1
XMP1 Y B VDD VDD sg13_lv_pmos w=1.0u l=0.13u ng=1 m=1
XMP2 Y C VDD VDD sg13_lv_pmos w=1.0u l=0.13u ng=1 m=1
XMP3 Y D VDD VDD sg13_lv_pmos w=1.0u l=0.13u ng=1 m=1
XMN0 Y A N1 VSS sg13_lv_nmos w=2.0u l=0.13u ng=1 m=1
XMN1 N1 B N2 VSS sg13_lv_nmos w=2.0u l=0.13u ng=1 m=1
XMN2 N2 C N3 VSS sg13_lv_nmos w=2.0u l=0.13u ng=1 m=1
XMN3 N3 D VSS VSS sg13_lv_nmos w=2.0u l=0.13u ng=1 m=1
**** begin user architecture code

* 4-input NAND, N 2.0 um stack / P 1.0 um

**** end user architecture code
.ends


* expanding   symbol:  decoder/wl_driver.sym # of pins=6
** sym_path: design/decoder/wl_driver.sym
** sch_path: design/decoder/wl_driver.sch
.subckt wl_driver X Y WLEN WL VDD VSS
*.ipin X
*.ipin Y
*.ipin WLEN
*.opin WL
*.iopin VDD
*.iopin VSS
XMPA WLB X VDD VDD sg13_lv_pmos w=1.0u l=0.13u ng=1 m=1
XMPB WLB Y VDD VDD sg13_lv_pmos w=1.0u l=0.13u ng=1 m=1
XMPC WLB WLEN VDD VDD sg13_lv_pmos w=1.0u l=0.13u ng=1 m=1
XMNA WLB X N1 VSS sg13_lv_nmos w=1.5u l=0.13u ng=1 m=1
XMNB N1 Y N2 VSS sg13_lv_nmos w=1.5u l=0.13u ng=1 m=1
XMNC N2 WLEN VSS VSS sg13_lv_nmos w=1.5u l=0.13u ng=1 m=1
XMPD WL WLB VDD VDD sg13_lv_pmos w=4.0u l=0.13u ng=1 m=1
XMND WL WLB VSS VSS sg13_lv_nmos w=2.0u l=0.13u ng=1 m=1
**** begin user architecture code

* one wordline: NAND3(X, Y, WLEN) then a 4x inverter driving WL

**** end user architecture code
.ends
