2AMLogic/sg13g2-sram/design/macro/macro.spice

** sch_path: design/macro/macro.sch

* 256 x 32 SRAM macro (128 rows x 64 columns, mux 2): A[0] selects the column, A[7:1] the row; one supply rail VDD/VSS

.subckt macro A[7] A[6] A[5] A[4] A[3] A[2] A[1] A[0] CEN CLK D[31] D[30] D[29] D[28] D[27] D[26] D[25] D[24] D[23] D[22] D[21]
+ D[20] D[19] D[18] D[17] D[16] D[15] D[14] D[13] D[12] D[11] D[10] D[9] D[8] D[7] D[6] D[5] D[4] D[3] D[2] D[1] D[0] Q[31] Q[30] Q[29]
+ Q[28] Q[27] Q[26] Q[25] Q[24] Q[23] Q[22] Q[21] Q[20] Q[19] Q[18] Q[17] Q[16] Q[15] Q[14] Q[13] Q[12] Q[11] Q[10] Q[9] Q[8] Q[7] Q[6]
+ Q[5] Q[4] Q[3] Q[2] Q[1] Q[0] GWEN WEN VDD VSS
*.ipin A[7]
*.ipin A[6]
*.ipin A[5]
*.ipin A[4]
*.ipin A[3]
*.ipin A[2]
*.ipin A[1]
*.ipin A[0]
*.ipin CEN
*.ipin CLK
*.ipin D[31]
*.ipin D[30]
*.ipin D[29]
*.ipin D[28]
*.ipin D[27]
*.ipin D[26]
*.ipin D[25]
*.ipin D[24]
*.ipin D[23]
*.ipin D[22]
*.ipin D[21]
*.ipin D[20]
*.ipin D[19]
*.ipin D[18]
*.ipin D[17]
*.ipin D[16]
*.ipin D[15]
*.ipin D[14]
*.ipin D[13]
*.ipin D[12]
*.ipin D[11]
*.ipin D[10]
*.ipin D[9]
*.ipin D[8]
*.ipin D[7]
*.ipin D[6]
*.ipin D[5]
*.ipin D[4]
*.ipin D[3]
*.ipin D[2]
*.ipin D[1]
*.ipin D[0]
*.opin Q[31]
*.opin Q[30]
*.opin Q[29]
*.opin Q[28]
*.opin Q[27]
*.opin Q[26]
*.opin Q[25]
*.opin Q[24]
*.opin Q[23]
*.opin Q[22]
*.opin Q[21]
*.opin Q[20]
*.opin Q[19]
*.opin Q[18]
*.opin Q[17]
*.opin Q[16]
*.opin Q[15]
*.opin Q[14]
*.opin Q[13]
*.opin Q[12]
*.opin Q[11]
*.opin Q[10]
*.opin Q[9]
*.opin Q[8]
*.opin Q[7]
*.opin Q[6]
*.opin Q[5]
*.opin Q[4]
*.opin Q[3]
*.opin Q[2]
*.opin Q[1]
*.opin Q[0]
*.ipin GWEN
*.ipin WEN
*.iopin VDD
*.iopin VSS
XAL CLK A[7] A[6] A[5] A[4] A[3] A[2] A[1] A[0] CEN GWEN WEN AL[7] AL[6] AL[5] AL[4] AL[3] AL[2] AL[1] AL[0] CENL GWENL WENL VDD
+ VSS addr_latch
XCTL CLK CENL GWENL WENL AL[0] PRE_B WLEN SAE WE SEL0 SEL0B SEL1 SEL1B VDD VSS control
XDEC AL[7] AL[6] AL[5] AL[4] AL[3] AL[2] AL[1] WLEN WL[127] WL[126] WL[125] WL[124] WL[123] WL[122] WL[121] WL[120] WL[119]
+ WL[118] WL[117] WL[116] WL[115] WL[114] WL[113] WL[112] WL[111] WL[110] WL[109] WL[108] WL[107] WL[106] WL[105] WL[104] WL[103] WL[102]
+ WL[101] WL[100] WL[99] WL[98] WL[97] WL[96] WL[95] WL[94] WL[93] WL[92] WL[91] WL[90] WL[89] WL[88] WL[87] WL[86] WL[85] WL[84] WL[83]
+ WL[82] WL[81] WL[80] WL[79] WL[78] WL[77] WL[76] WL[75] WL[74] WL[73] WL[72] WL[71] WL[70] WL[69] WL[68] WL[67] WL[66] WL[65] WL[64]
+ WL[63] WL[62] WL[61] WL[60] WL[59] WL[58] WL[57] WL[56] WL[55] WL[54] WL[53] WL[52] WL[51] WL[50] WL[49] WL[48] WL[47] WL[46] WL[45]
+ WL[44] WL[43] WL[42] WL[41] WL[40] WL[39] WL[38] WL[37] WL[36] WL[35] WL[34] WL[33] WL[32] WL[31] WL[30] WL[29] WL[28] WL[27] WL[26]
+ WL[25] WL[24] WL[23] WL[22] WL[21] WL[20] WL[19] WL[18] WL[17] WL[16] WL[15] WL[14] WL[13] WL[12] WL[11] WL[10] WL[9] WL[8] WL[7] WL[6]
+ WL[5] WL[4] WL[3] WL[2] WL[1] WL[0] VDD VSS row_decoder
XDL CLK D[31] D[30] D[29] D[28] D[27] D[26] D[25] D[24] D[23] D[22] D[21] D[20] D[19] D[18] D[17] D[16] D[15] D[14] D[13] D[12]
+ D[11] D[10] D[9] D[8] D[7] D[6] D[5] D[4] D[3] D[2] D[1] D[0] DL[31] DL[30] DL[29] DL[28] DL[27] DL[26] DL[25] DL[24] DL[23] DL[22]
+ DL[21] DL[20] DL[19] DL[18] DL[17] DL[16] DL[15] DL[14] DL[13] DL[12] DL[11] DL[10] DL[9] DL[8] DL[7] DL[6] DL[5] DL[4] DL[3] DL[2]
+ DL[1] DL[0] VDD VSS data_latch
XS[31] PRE_B SEL0 SEL0B SEL1 SEL1B SAE WE DL[31] WL[127] WL[126] WL[125] WL[124] WL[123] WL[122] WL[121] WL[120] WL[119] WL[118]
+ WL[117] WL[116] WL[115] WL[114] WL[113] WL[112] WL[111] WL[110] WL[109] WL[108] WL[107] WL[106] WL[105] WL[104] WL[103] WL[102] WL[101]
+ WL[100] WL[99] WL[98] WL[97] WL[96] WL[95] WL[94] WL[93] WL[92] WL[91] WL[90] WL[89] WL[88] WL[87] WL[86] WL[85] WL[84] WL[83] WL[82]
+ WL[81] WL[80] WL[79] WL[78] WL[77] WL[76] WL[75] WL[74] WL[73] WL[72] WL[71] WL[70] WL[69] WL[68] WL[67] WL[66] WL[65] WL[64] WL[63]
+ WL[62] WL[61] WL[60] WL[59] WL[58] WL[57] WL[56] WL[55] WL[54] WL[53] WL[52] WL[51] WL[50] WL[49] WL[48] WL[47] WL[46] WL[45] WL[44]
+ WL[43] WL[42] WL[41] WL[40] WL[39] WL[38] WL[37] WL[36] WL[35] WL[34] WL[33] WL[32] WL[31] WL[30] WL[29] WL[28] WL[27] WL[26] WL[25]
+ WL[24] WL[23] WL[22] WL[21] WL[20] WL[19] WL[18] WL[17] WL[16] WL[15] WL[14] WL[13] WL[12] WL[11] WL[10] WL[9] WL[8] WL[7] WL[6] WL[5]
+ WL[4] WL[3] WL[2] WL[1] WL[0] DOUT[31] DOUTB[31] VDD VSS bit_slice
XS[30] PRE_B SEL0 SEL0B SEL1 SEL1B SAE WE DL[30] WL[127] WL[126] WL[125] WL[124] WL[123] WL[122] WL[121] WL[120] WL[119] WL[118]
+ WL[117] WL[116] WL[115] WL[114] WL[113] WL[112] WL[111] WL[110] WL[109] WL[108] WL[107] WL[106] WL[105] WL[104] WL[103] WL[102] WL[101]
+ WL[100] WL[99] WL[98] WL[97] WL[96] WL[95] WL[94] WL[93] WL[92] WL[91] WL[90] WL[89] WL[88] WL[87] WL[86] WL[85] WL[84] WL[83] WL[82]
+ WL[81] WL[80] WL[79] WL[78] WL[77] WL[76] WL[75] WL[74] WL[73] WL[72] WL[71] WL[70] WL[69] WL[68] WL[67] WL[66] WL[65] WL[64] WL[63]
+ WL[62] WL[61] WL[60] WL[59] WL[58] WL[57] WL[56] WL[55] WL[54] WL[53] WL[52] WL[51] WL[50] WL[49] WL[48] WL[47] WL[46] WL[45] WL[44]
+ WL[43] WL[42] WL[41] WL[40] WL[39] WL[38] WL[37] WL[36] WL[35] WL[34] WL[33] WL[32] WL[31] WL[30] WL[29] WL[28] WL[27] WL[26] WL[25]
+ WL[24] WL[23] WL[22] WL[21] WL[20] WL[19] WL[18] WL[17] WL[16] WL[15] WL[14] WL[13] WL[12] WL[11] WL[10] WL[9] WL[8] WL[7] WL[6] WL[5]
+ WL[4] WL[3] WL[2] WL[1] WL[0] DOUT[30] DOUTB[30] VDD VSS bit_slice
XS[29] PRE_B SEL0 SEL0B SEL1 SEL1B SAE WE DL[29] WL[127] WL[126] WL[125] WL[124] WL[123] WL[122] WL[121] WL[120] WL[119] WL[118]
+ WL[117] WL[116] WL[115] WL[114] WL[113] WL[112] WL[111] WL[110] WL[109] WL[108] WL[107] WL[106] WL[105] WL[104] WL[103] WL[102] WL[101]
+ WL[100] WL[99] WL[98] WL[97] WL[96] WL[95] WL[94] WL[93] WL[92] WL[91] WL[90] WL[89] WL[88] WL[87] WL[86] WL[85] WL[84] WL[83] WL[82]
+ WL[81] WL[80] WL[79] WL[78] WL[77] WL[76] WL[75] WL[74] WL[73] WL[72] WL[71] WL[70] WL[69] WL[68] WL[67] WL[66] WL[65] WL[64] WL[63]
+ WL[62] WL[61] WL[60] WL[59] WL[58] WL[57] WL[56] WL[55] WL[54] WL[53] WL[52] WL[51] WL[50] WL[49] WL[48] WL[47] WL[46] WL[45] WL[44]
+ WL[43] WL[42] WL[41] WL[40] WL[39] WL[38] WL[37] WL[36] WL[35] WL[34] WL[33] WL[32] WL[31] WL[30] WL[29] WL[28] WL[27] WL[26] WL[25]
+ WL[24] WL[23] WL[22] WL[21] WL[20] WL[19] WL[18] WL[17] WL[16] WL[15] WL[14] WL[13] WL[12] WL[11] WL[10] WL[9] WL[8] WL[7] WL[6] WL[5]
+ WL[4] WL[3] WL[2] WL[1] WL[0] DOUT[29] DOUTB[29] VDD VSS bit_slice
XS[28] PRE_B SEL0 SEL0B SEL1 SEL1B SAE WE DL[28] WL[127] WL[126] WL[125] WL[124] WL[123] WL[122] WL[121] WL[120] WL[119] WL[118]
+ WL[117] WL[116] WL[115] WL[114] WL[113] WL[112] WL[111] WL[110] WL[109] WL[108] WL[107] WL[106] WL[105] WL[104] WL[103] WL[102] WL[101]
+ WL[100] WL[99] WL[98] WL[97] WL[96] WL[95] WL[94] WL[93] WL[92] WL[91] WL[90] WL[89] WL[88] WL[87] WL[86] WL[85] WL[84] WL[83] WL[82]
+ WL[81] WL[80] WL[79] WL[78] WL[77] WL[76] WL[75] WL[74] WL[73] WL[72] WL[71] WL[70] WL[69] WL[68] WL[67] WL[66] WL[65] WL[64] WL[63]
+ WL[62] WL[61] WL[60] WL[59] WL[58] WL[57] WL[56] WL[55] WL[54] WL[53] WL[52] WL[51] WL[50] WL[49] WL[48] WL[47] WL[46] WL[45] WL[44]
+ WL[43] WL[42] WL[41] WL[40] WL[39] WL[38] WL[37] WL[36] WL[35] WL[34] WL[33] WL[32] WL[31] WL[30] WL[29] WL[28] WL[27] WL[26] WL[25]
+ WL[24] WL[23] WL[22] WL[21] WL[20] WL[19] WL[18] WL[17] WL[16] WL[15] WL[14] WL[13] WL[12] WL[11] WL[10] WL[9] WL[8] WL[7] WL[6] WL[5]
+ WL[4] WL[3] WL[2] WL[1] WL[0] DOUT[28] DOUTB[28] VDD VSS bit_slice
XS[27] PRE_B SEL0 SEL0B SEL1 SEL1B SAE WE DL[27] WL[127] WL[126] WL[125] WL[124] WL[123] WL[122] WL[121] WL[120] WL[119] WL[118]
+ WL[117] WL[116] WL[115] WL[114] WL[113] WL[112] WL[111] WL[110] WL[109] WL[108] WL[107] WL[106] WL[105] WL[104] WL[103] WL[102] WL[101]
+ WL[100] WL[99] WL[98] WL[97] WL[96] WL[95] WL[94] WL[93] WL[92] WL[91] WL[90] WL[89] WL[88] WL[87] WL[86] WL[85] WL[84] WL[83] WL[82]
+ WL[81] WL[80] WL[79] WL[78] WL[77] WL[76] WL[75] WL[74] WL[73] WL[72] WL[71] WL[70] WL[69] WL[68] WL[67] WL[66] WL[65] WL[64] WL[63]
+ WL[62] WL[61] WL[60] WL[59] WL[58] WL[57] WL[56] WL[55] WL[54] WL[53] WL[52] WL[51] WL[50] WL[49] WL[48] WL[47] WL[46] WL[45] WL[44]
+ WL[43] WL[42] WL[41] WL[40] WL[39] WL[38] WL[37] WL[36] WL[35] WL[34] WL[33] WL[32] WL[31] WL[30] WL[29] WL[28] WL[27] WL[26] WL[25]
+ WL[24] WL[23] WL[22] WL[21] WL[20] WL[19] WL[18] WL[17] WL[16] WL[15] WL[14] WL[13] WL[12] WL[11] WL[10] WL[9] WL[8] WL[7] WL[6] WL[5]
+ WL[4] WL[3] WL[2] WL[1] WL[0] DOUT[27] DOUTB[27] VDD VSS bit_slice
XS[26] PRE_B SEL0 SEL0B SEL1 SEL1B SAE WE DL[26] WL[127] WL[126] WL[125] WL[124] WL[123] WL[122] WL[121] WL[120] WL[119] WL[118]
+ WL[117] WL[116] WL[115] WL[114] WL[113] WL[112] WL[111] WL[110] WL[109] WL[108] WL[107] WL[106] WL[105] WL[104] WL[103] WL[102] WL[101]
+ WL[100] WL[99] WL[98] WL[97] WL[96] WL[95] WL[94] WL[93] WL[92] WL[91] WL[90] WL[89] WL[88] WL[87] WL[86] WL[85] WL[84] WL[83] WL[82]
+ WL[81] WL[80] WL[79] WL[78] WL[77] WL[76] WL[75] WL[74] WL[73] WL[72] WL[71] WL[70] WL[69] WL[68] WL[67] WL[66] WL[65] WL[64] WL[63]
+ WL[62] WL[61] WL[60] WL[59] WL[58] WL[57] WL[56] WL[55] WL[54] WL[53] WL[52] WL[51] WL[50] WL[49] WL[48] WL[47] WL[46] WL[45] WL[44]
+ WL[43] WL[42] WL[41] WL[40] WL[39] WL[38] WL[37] WL[36] WL[35] WL[34] WL[33] WL[32] WL[31] WL[30] WL[29] WL[28] WL[27] WL[26] WL[25]
+ WL[24] WL[23] WL[22] WL[21] WL[20] WL[19] WL[18] WL[17] WL[16] WL[15] WL[14] WL[13] WL[12] WL[11] WL[10] WL[9] WL[8] WL[7] WL[6] WL[5]
+ WL[4] WL[3] WL[2] WL[1] WL[0] DOUT[26] DOUTB[26] VDD VSS bit_slice
XS[25] PRE_B SEL0 SEL0B SEL1 SEL1B SAE WE DL[25] WL[127] WL[126] WL[125] WL[124] WL[123] WL[122] WL[121] WL[120] WL[119] WL[118]
+ WL[117] WL[116] WL[115] WL[114] WL[113] WL[112] WL[111] WL[110] WL[109] WL[108] WL[107] WL[106] WL[105] WL[104] WL[103] WL[102] WL[101]
+ WL[100] WL[99] WL[98] WL[97] WL[96] WL[95] WL[94] WL[93] WL[92] WL[91] WL[90] WL[89] WL[88] WL[87] WL[86] WL[85] WL[84] WL[83] WL[82]
+ WL[81] WL[80] WL[79] WL[78] WL[77] WL[76] WL[75] WL[74] WL[73] WL[72] WL[71] WL[70] WL[69] WL[68] WL[67] WL[66] WL[65] WL[64] WL[63]
+ WL[62] WL[61] WL[60] WL[59] WL[58] WL[57] WL[56] WL[55] WL[54] WL[53] WL[52] WL[51] WL[50] WL[49] WL[48] WL[47] WL[46] WL[45] WL[44]
+ WL[43] WL[42] WL[41] WL[40] WL[39] WL[38] WL[37] WL[36] WL[35] WL[34] WL[33] WL[32] WL[31] WL[30] WL[29] WL[28] WL[27] WL[26] WL[25]
+ WL[24] WL[23] WL[22] WL[21] WL[20] WL[19] WL[18] WL[17] WL[16] WL[15] WL[14] WL[13] WL[12] WL[11] WL[10] WL[9] WL[8] WL[7] WL[6] WL[5]
+ WL[4] WL[3] WL[2] WL[1] WL[0] DOUT[25] DOUTB[25] VDD VSS bit_slice
XS[24] PRE_B SEL0 SEL0B SEL1 SEL1B SAE WE DL[24] WL[127] WL[126] WL[125] WL[124] WL[123] WL[122] WL[121] WL[120] WL[119] WL[118]
+ WL[117] WL[116] WL[115] WL[114] WL[113] WL[112] WL[111] WL[110] WL[109] WL[108] WL[107] WL[106] WL[105] WL[104] WL[103] WL[102] WL[101]
+ WL[100] WL[99] WL[98] WL[97] WL[96] WL[95] WL[94] WL[93] WL[92] WL[91] WL[90] WL[89] WL[88] WL[87] WL[86] WL[85] WL[84] WL[83] WL[82]
+ WL[81] WL[80] WL[79] WL[78] WL[77] WL[76] WL[75] WL[74] WL[73] WL[72] WL[71] WL[70] WL[69] WL[68] WL[67] WL[66] WL[65] WL[64] WL[63]
+ WL[62] WL[61] WL[60] WL[59] WL[58] WL[57] WL[56] WL[55] WL[54] WL[53] WL[52] WL[51] WL[50] WL[49] WL[48] WL[47] WL[46] WL[45] WL[44]
+ WL[43] WL[42] WL[41] WL[40] WL[39] WL[38] WL[37] WL[36] WL[35] WL[34] WL[33] WL[32] WL[31] WL[30] WL[29] WL[28] WL[27] WL[26] WL[25]
+ WL[24] WL[23] WL[22] WL[21] WL[20] WL[19] WL[18] WL[17] WL[16] WL[15] WL[14] WL[13] WL[12] WL[11] WL[10] WL[9] WL[8] WL[7] WL[6] WL[5]
+ WL[4] WL[3] WL[2] WL[1] WL[0] DOUT[24] DOUTB[24] VDD VSS bit_slice
XS[23] PRE_B SEL0 SEL0B SEL1 SEL1B SAE WE DL[23] WL[127] WL[126] WL[125] WL[124] WL[123] WL[122] WL[121] WL[120] WL[119] WL[118]
+ WL[117] WL[116] WL[115] WL[114] WL[113] WL[112] WL[111] WL[110] WL[109] WL[108] WL[107] WL[106] WL[105] WL[104] WL[103] WL[102] WL[101]
+ WL[100] WL[99] WL[98] WL[97] WL[96] WL[95] WL[94] WL[93] WL[92] WL[91] WL[90] WL[89] WL[88] WL[87] WL[86] WL[85] WL[84] WL[83] WL[82]
+ WL[81] WL[80] WL[79] WL[78] WL[77] WL[76] WL[75] WL[74] WL[73] WL[72] WL[71] WL[70] WL[69] WL[68] WL[67] WL[66] WL[65] WL[64] WL[63]
+ WL[62] WL[61] WL[60] WL[59] WL[58] WL[57] WL[56] WL[55] WL[54] WL[53] WL[52] WL[51] WL[50] WL[49] WL[48] WL[47] WL[46] WL[45] WL[44]
+ WL[43] WL[42] WL[41] WL[40] WL[39] WL[38] WL[37] WL[36] WL[35] WL[34] WL[33] WL[32] WL[31] WL[30] WL[29] WL[28] WL[27] WL[26] WL[25]
+ WL[24] WL[23] WL[22] WL[21] WL[20] WL[19] WL[18] WL[17] WL[16] WL[15] WL[14] WL[13] WL[12] WL[11] WL[10] WL[9] WL[8] WL[7] WL[6] WL[5]
+ WL[4] WL[3] WL[2] WL[1] WL[0] DOUT[23] DOUTB[23] VDD VSS bit_slice
XS[22] PRE_B SEL0 SEL0B SEL1 SEL1B SAE WE DL[22] WL[127] WL[126] WL[125] WL[124] WL[123] WL[122] WL[121] WL[120] WL[119] WL[118]
+ WL[117] WL[116] WL[115] WL[114] WL[113] WL[112] WL[111] WL[110] WL[109] WL[108] WL[107] WL[106] WL[105] WL[104] WL[103] WL[102] WL[101]
+ WL[100] WL[99] WL[98] WL[97] WL[96] WL[95] WL[94] WL[93] WL[92] WL[91] WL[90] WL[89] WL[88] WL[87] WL[86] WL[85] WL[84] WL[83] WL[82]
+ WL[81] WL[80] WL[79] WL[78] WL[77] WL[76] WL[75] WL[74] WL[73] WL[72] WL[71] WL[70] WL[69] WL[68] WL[67] WL[66] WL[65] WL[64] WL[63]
+ WL[62] WL[61] WL[60] WL[59] WL[58] WL[57] WL[56] WL[55] WL[54] WL[53] WL[52] WL[51] WL[50] WL[49] WL[48] WL[47] WL[46] WL[45] WL[44]
+ WL[43] WL[42] WL[41] WL[40] WL[39] WL[38] WL[37] WL[36] WL[35] WL[34] WL[33] WL[32] WL[31] WL[30] WL[29] WL[28] WL[27] WL[26] WL[25]
+ WL[24] WL[23] WL[22] WL[21] WL[20] WL[19] WL[18] WL[17] WL[16] WL[15] WL[14] WL[13] WL[12] WL[11] WL[10] WL[9] WL[8] WL[7] WL[6] WL[5]
+ WL[4] WL[3] WL[2] WL[1] WL[0] DOUT[22] DOUTB[22] VDD VSS bit_slice
XS[21] PRE_B SEL0 SEL0B SEL1 SEL1B SAE WE DL[21] WL[127] WL[126] WL[125] WL[124] WL[123] WL[122] WL[121] WL[120] WL[119] WL[118]
+ WL[117] WL[116] WL[115] WL[114] WL[113] WL[112] WL[111] WL[110] WL[109] WL[108] WL[107] WL[106] WL[105] WL[104] WL[103] WL[102] WL[101]
+ WL[100] WL[99] WL[98] WL[97] WL[96] WL[95] WL[94] WL[93] WL[92] WL[91] WL[90] WL[89] WL[88] WL[87] WL[86] WL[85] WL[84] WL[83] WL[82]
+ WL[81] WL[80] WL[79] WL[78] WL[77] WL[76] WL[75] WL[74] WL[73] WL[72] WL[71] WL[70] WL[69] WL[68] WL[67] WL[66] WL[65] WL[64] WL[63]
+ WL[62] WL[61] WL[60] WL[59] WL[58] WL[57] WL[56] WL[55] WL[54] WL[53] WL[52] WL[51] WL[50] WL[49] WL[48] WL[47] WL[46] WL[45] WL[44]
+ WL[43] WL[42] WL[41] WL[40] WL[39] WL[38] WL[37] WL[36] WL[35] WL[34] WL[33] WL[32] WL[31] WL[30] WL[29] WL[28] WL[27] WL[26] WL[25]
+ WL[24] WL[23] WL[22] WL[21] WL[20] WL[19] WL[18] WL[17] WL[16] WL[15] WL[14] WL[13] WL[12] WL[11] WL[10] WL[9] WL[8] WL[7] WL[6] WL[5]
+ WL[4] WL[3] WL[2] WL[1] WL[0] DOUT[21] DOUTB[21] VDD VSS bit_slice
XS[20] PRE_B SEL0 SEL0B SEL1 SEL1B SAE WE DL[20] WL[127] WL[126] WL[125] WL[124] WL[123] WL[122] WL[121] WL[120] WL[119] WL[118]
+ WL[117] WL[116] WL[115] WL[114] WL[113] WL[112] WL[111] WL[110] WL[109] WL[108] WL[107] WL[106] WL[105] WL[104] WL[103] WL[102] WL[101]
+ WL[100] WL[99] WL[98] WL[97] WL[96] WL[95] WL[94] WL[93] WL[92] WL[91] WL[90] WL[89] WL[88] WL[87] WL[86] WL[85] WL[84] WL[83] WL[82]
+ WL[81] WL[80] WL[79] WL[78] WL[77] WL[76] WL[75] WL[74] WL[73] WL[72] WL[71] WL[70] WL[69] WL[68] WL[67] WL[66] WL[65] WL[64] WL[63]
+ WL[62] WL[61] WL[60] WL[59] WL[58] WL[57] WL[56] WL[55] WL[54] WL[53] WL[52] WL[51] WL[50] WL[49] WL[48] WL[47] WL[46] WL[45] WL[44]
+ WL[43] WL[42] WL[41] WL[40] WL[39] WL[38] WL[37] WL[36] WL[35] WL[34] WL[33] WL[32] WL[31] WL[30] WL[29] WL[28] WL[27] WL[26] WL[25]
+ WL[24] WL[23] WL[22] WL[21] WL[20] WL[19] WL[18] WL[17] WL[16] WL[15] WL[14] WL[13] WL[12] WL[11] WL[10] WL[9] WL[8] WL[7] WL[6] WL[5]
+ WL[4] WL[3] WL[2] WL[1] WL[0] DOUT[20] DOUTB[20] VDD VSS bit_slice
XS[19] PRE_B SEL0 SEL0B SEL1 SEL1B SAE WE DL[19] WL[127] WL[126] WL[125] WL[124] WL[123] WL[122] WL[121] WL[120] WL[119] WL[118]
+ WL[117] WL[116] WL[115] WL[114] WL[113] WL[112] WL[111] WL[110] WL[109] WL[108] WL[107] WL[106] WL[105] WL[104] WL[103] WL[102] WL[101]
+ WL[100] WL[99] WL[98] WL[97] WL[96] WL[95] WL[94] WL[93] WL[92] WL[91] WL[90] WL[89] WL[88] WL[87] WL[86] WL[85] WL[84] WL[83] WL[82]
+ WL[81] WL[80] WL[79] WL[78] WL[77] WL[76] WL[75] WL[74] WL[73] WL[72] WL[71] WL[70] WL[69] WL[68] WL[67] WL[66] WL[65] WL[64] WL[63]
+ WL[62] WL[61] WL[60] WL[59] WL[58] WL[57] WL[56] WL[55] WL[54] WL[53] WL[52] WL[51] WL[50] WL[49] WL[48] WL[47] WL[46] WL[45] WL[44]
+ WL[43] WL[42] WL[41] WL[40] WL[39] WL[38] WL[37] WL[36] WL[35] WL[34] WL[33] WL[32] WL[31] WL[30] WL[29] WL[28] WL[27] WL[26] WL[25]
+ WL[24] WL[23] WL[22] WL[21] WL[20] WL[19] WL[18] WL[17] WL[16] WL[15] WL[14] WL[13] WL[12] WL[11] WL[10] WL[9] WL[8] WL[7] WL[6] WL[5]
+ WL[4] WL[3] WL[2] WL[1] WL[0] DOUT[19] DOUTB[19] VDD VSS bit_slice
XS[18] PRE_B SEL0 SEL0B SEL1 SEL1B SAE WE DL[18] WL[127] WL[126] WL[125] WL[124] WL[123] WL[122] WL[121] WL[120] WL[119] WL[118]
+ WL[117] WL[116] WL[115] WL[114] WL[113] WL[112] WL[111] WL[110] WL[109] WL[108] WL[107] WL[106] WL[105] WL[104] WL[103] WL[102] WL[101]
+ WL[100] WL[99] WL[98] WL[97] WL[96] WL[95] WL[94] WL[93] WL[92] WL[91] WL[90] WL[89] WL[88] WL[87] WL[86] WL[85] WL[84] WL[83] WL[82]
+ WL[81] WL[80] WL[79] WL[78] WL[77] WL[76] WL[75] WL[74] WL[73] WL[72] WL[71] WL[70] WL[69] WL[68] WL[67] WL[66] WL[65] WL[64] WL[63]
+ WL[62] WL[61] WL[60] WL[59] WL[58] WL[57] WL[56] WL[55] WL[54] WL[53] WL[52] WL[51] WL[50] WL[49] WL[48] WL[47] WL[46] WL[45] WL[44]
+ WL[43] WL[42] WL[41] WL[40] WL[39] WL[38] WL[37] WL[36] WL[35] WL[34] WL[33] WL[32] WL[31] WL[30] WL[29] WL[28] WL[27] WL[26] WL[25]
+ WL[24] WL[23] WL[22] WL[21] WL[20] WL[19] WL[18] WL[17] WL[16] WL[15] WL[14] WL[13] WL[12] WL[11] WL[10] WL[9] WL[8] WL[7] WL[6] WL[5]
+ WL[4] WL[3] WL[2] WL[1] WL[0] DOUT[18] DOUTB[18] VDD VSS bit_slice
XS[17] PRE_B SEL0 SEL0B SEL1 SEL1B SAE WE DL[17] WL[127] WL[126] WL[125] WL[124] WL[123] WL[122] WL[121] WL[120] WL[119] WL[118]
+ WL[117] WL[116] WL[115] WL[114] WL[113] WL[112] WL[111] WL[110] WL[109] WL[108] WL[107] WL[106] WL[105] WL[104] WL[103] WL[102] WL[101]
+ WL[100] WL[99] WL[98] WL[97] WL[96] WL[95] WL[94] WL[93] WL[92] WL[91] WL[90] WL[89] WL[88] WL[87] WL[86] WL[85] WL[84] WL[83] WL[82]
+ WL[81] WL[80] WL[79] WL[78] WL[77] WL[76] WL[75] WL[74] WL[73] WL[72] WL[71] WL[70] WL[69] WL[68] WL[67] WL[66] WL[65] WL[64] WL[63]
+ WL[62] WL[61] WL[60] WL[59] WL[58] WL[57] WL[56] WL[55] WL[54] WL[53] WL[52] WL[51] WL[50] WL[49] WL[48] WL[47] WL[46] WL[45] WL[44]
+ WL[43] WL[42] WL[41] WL[40] WL[39] WL[38] WL[37] WL[36] WL[35] WL[34] WL[33] WL[32] WL[31] WL[30] WL[29] WL[28] WL[27] WL[26] WL[25]
+ WL[24] WL[23] WL[22] WL[21] WL[20] WL[19] WL[18] WL[17] WL[16] WL[15] WL[14] WL[13] WL[12] WL[11] WL[10] WL[9] WL[8] WL[7] WL[6] WL[5]
+ WL[4] WL[3] WL[2] WL[1] WL[0] DOUT[17] DOUTB[17] VDD VSS bit_slice
XS[16] PRE_B SEL0 SEL0B SEL1 SEL1B SAE WE DL[16] WL[127] WL[126] WL[125] WL[124] WL[123] WL[122] WL[121] WL[120] WL[119] WL[118]
+ WL[117] WL[116] WL[115] WL[114] WL[113] WL[112] WL[111] WL[110] WL[109] WL[108] WL[107] WL[106] WL[105] WL[104] WL[103] WL[102] WL[101]
+ WL[100] WL[99] WL[98] WL[97] WL[96] WL[95] WL[94] WL[93] WL[92] WL[91] WL[90] WL[89] WL[88] WL[87] WL[86] WL[85] WL[84] WL[83] WL[82]
+ WL[81] WL[80] WL[79] WL[78] WL[77] WL[76] WL[75] WL[74] WL[73] WL[72] WL[71] WL[70] WL[69] WL[68] WL[67] WL[66] WL[65] WL[64] WL[63]
+ WL[62] WL[61] WL[60] WL[59] WL[58] WL[57] WL[56] WL[55] WL[54] WL[53] WL[52] WL[51] WL[50] WL[49] WL[48] WL[47] WL[46] WL[45] WL[44]
+ WL[43] WL[42] WL[41] WL[40] WL[39] WL[38] WL[37] WL[36] WL[35] WL[34] WL[33] WL[32] WL[31] WL[30] WL[29] WL[28] WL[27] WL[26] WL[25]
+ WL[24] WL[23] WL[22] WL[21] WL[20] WL[19] WL[18] WL[17] WL[16] WL[15] WL[14] WL[13] WL[12] WL[11] WL[10] WL[9] WL[8] WL[7] WL[6] WL[5]
+ WL[4] WL[3] WL[2] WL[1] WL[0] DOUT[16] DOUTB[16] VDD VSS bit_slice
XS[15] PRE_B SEL0 SEL0B SEL1 SEL1B SAE WE DL[15] WL[127] WL[126] WL[125] WL[124] WL[123] WL[122] WL[121] WL[120] WL[119] WL[118]
+ WL[117] WL[116] WL[115] WL[114] WL[113] WL[112] WL[111] WL[110] WL[109] WL[108] WL[107] WL[106] WL[105] WL[104] WL[103] WL[102] WL[101]
+ WL[100] WL[99] WL[98] WL[97] WL[96] WL[95] WL[94] WL[93] WL[92] WL[91] WL[90] WL[89] WL[88] WL[87] WL[86] WL[85] WL[84] WL[83] WL[82]
+ WL[81] WL[80] WL[79] WL[78] WL[77] WL[76] WL[75] WL[74] WL[73] WL[72] WL[71] WL[70] WL[69] WL[68] WL[67] WL[66] WL[65] WL[64] WL[63]
+ WL[62] WL[61] WL[60] WL[59] WL[58] WL[57] WL[56] WL[55] WL[54] WL[53] WL[52] WL[51] WL[50] WL[49] WL[48] WL[47] WL[46] WL[45] WL[44]
+ WL[43] WL[42] WL[41] WL[40] WL[39] WL[38] WL[37] WL[36] WL[35] WL[34] WL[33] WL[32] WL[31] WL[30] WL[29] WL[28] WL[27] WL[26] WL[25]
+ WL[24] WL[23] WL[22] WL[21] WL[20] WL[19] WL[18] WL[17] WL[16] WL[15] WL[14] WL[13] WL[12] WL[11] WL[10] WL[9] WL[8] WL[7] WL[6] WL[5]
+ WL[4] WL[3] WL[2] WL[1] WL[0] DOUT[15] DOUTB[15] VDD VSS bit_slice
XS[14] PRE_B SEL0 SEL0B SEL1 SEL1B SAE WE DL[14] WL[127] WL[126] WL[125] WL[124] WL[123] WL[122] WL[121] WL[120] WL[119] WL[118]
+ WL[117] WL[116] WL[115] WL[114] WL[113] WL[112] WL[111] WL[110] WL[109] WL[108] WL[107] WL[106] WL[105] WL[104] WL[103] WL[102] WL[101]
+ WL[100] WL[99] WL[98] WL[97] WL[96] WL[95] WL[94] WL[93] WL[92] WL[91] WL[90] WL[89] WL[88] WL[87] WL[86] WL[85] WL[84] WL[83] WL[82]
+ WL[81] WL[80] WL[79] WL[78] WL[77] WL[76] WL[75] WL[74] WL[73] WL[72] WL[71] WL[70] WL[69] WL[68] WL[67] WL[66] WL[65] WL[64] WL[63]
+ WL[62] WL[61] WL[60] WL[59] WL[58] WL[57] WL[56] WL[55] WL[54] WL[53] WL[52] WL[51] WL[50] WL[49] WL[48] WL[47] WL[46] WL[45] WL[44]
+ WL[43] WL[42] WL[41] WL[40] WL[39] WL[38] WL[37] WL[36] WL[35] WL[34] WL[33] WL[32] WL[31] WL[30] WL[29] WL[28] WL[27] WL[26] WL[25]
+ WL[24] WL[23] WL[22] WL[21] WL[20] WL[19] WL[18] WL[17] WL[16] WL[15] WL[14] WL[13] WL[12] WL[11] WL[10] WL[9] WL[8] WL[7] WL[6] WL[5]
+ WL[4] WL[3] WL[2] WL[1] WL[0] DOUT[14] DOUTB[14] VDD VSS bit_slice
XS[13] PRE_B SEL0 SEL0B SEL1 SEL1B SAE WE DL[13] WL[127] WL[126] WL[125] WL[124] WL[123] WL[122] WL[121] WL[120] WL[119] WL[118]
+ WL[117] WL[116] WL[115] WL[114] WL[113] WL[112] WL[111] WL[110] WL[109] WL[108] WL[107] WL[106] WL[105] WL[104] WL[103] WL[102] WL[101]
+ WL[100] WL[99] WL[98] WL[97] WL[96] WL[95] WL[94] WL[93] WL[92] WL[91] WL[90] WL[89] WL[88] WL[87] WL[86] WL[85] WL[84] WL[83] WL[82]
+ WL[81] WL[80] WL[79] WL[78] WL[77] WL[76] WL[75] WL[74] WL[73] WL[72] WL[71] WL[70] WL[69] WL[68] WL[67] WL[66] WL[65] WL[64] WL[63]
+ WL[62] WL[61] WL[60] WL[59] WL[58] WL[57] WL[56] WL[55] WL[54] WL[53] WL[52] WL[51] WL[50] WL[49] WL[48] WL[47] WL[46] WL[45] WL[44]
+ WL[43] WL[42] WL[41] WL[40] WL[39] WL[38] WL[37] WL[36] WL[35] WL[34] WL[33] WL[32] WL[31] WL[30] WL[29] WL[28] WL[27] WL[26] WL[25]
+ WL[24] WL[23] WL[22] WL[21] WL[20] WL[19] WL[18] WL[17] WL[16] WL[15] WL[14] WL[13] WL[12] WL[11] WL[10] WL[9] WL[8] WL[7] WL[6] WL[5]
+ WL[4] WL[3] WL[2] WL[1] WL[0] DOUT[13] DOUTB[13] VDD VSS bit_slice
XS[12] PRE_B SEL0 SEL0B SEL1 SEL1B SAE WE DL[12] WL[127] WL[126] WL[125] WL[124] WL[123] WL[122] WL[121] WL[120] WL[119] WL[118]
+ WL[117] WL[116] WL[115] WL[114] WL[113] WL[112] WL[111] WL[110] WL[109] WL[108] WL[107] WL[106] WL[105] WL[104] WL[103] WL[102] WL[101]
+ WL[100] WL[99] WL[98] WL[97] WL[96] WL[95] WL[94] WL[93] WL[92] WL[91] WL[90] WL[89] WL[88] WL[87] WL[86] WL[85] WL[84] WL[83] WL[82]
+ WL[81] WL[80] WL[79] WL[78] WL[77] WL[76] WL[75] WL[74] WL[73] WL[72] WL[71] WL[70] WL[69] WL[68] WL[67] WL[66] WL[65] WL[64] WL[63]
+ WL[62] WL[61] WL[60] WL[59] WL[58] WL[57] WL[56] WL[55] WL[54] WL[53] WL[52] WL[51] WL[50] WL[49] WL[48] WL[47] WL[46] WL[45] WL[44]
+ WL[43] WL[42] WL[41] WL[40] WL[39] WL[38] WL[37] WL[36] WL[35] WL[34] WL[33] WL[32] WL[31] WL[30] WL[29] WL[28] WL[27] WL[26] WL[25]
+ WL[24] WL[23] WL[22] WL[21] WL[20] WL[19] WL[18] WL[17] WL[16] WL[15] WL[14] WL[13] WL[12] WL[11] WL[10] WL[9] WL[8] WL[7] WL[6] WL[5]
+ WL[4] WL[3] WL[2] WL[1] WL[0] DOUT[12] DOUTB[12] VDD VSS bit_slice
XS[11] PRE_B SEL0 SEL0B SEL1 SEL1B SAE WE DL[11] WL[127] WL[126] WL[125] WL[124] WL[123] WL[122] WL[121] WL[120] WL[119] WL[118]
+ WL[117] WL[116] WL[115] WL[114] WL[113] WL[112] WL[111] WL[110] WL[109] WL[108] WL[107] WL[106] WL[105] WL[104] WL[103] WL[102] WL[101]
+ WL[100] WL[99] WL[98] WL[97] WL[96] WL[95] WL[94] WL[93] WL[92] WL[91] WL[90] WL[89] WL[88] WL[87] WL[86] WL[85] WL[84] WL[83] WL[82]
+ WL[81] WL[80] WL[79] WL[78] WL[77] WL[76] WL[75] WL[74] WL[73] WL[72] WL[71] WL[70] WL[69] WL[68] WL[67] WL[66] WL[65] WL[64] WL[63]
+ WL[62] WL[61] WL[60] WL[59] WL[58] WL[57] WL[56] WL[55] WL[54] WL[53] WL[52] WL[51] WL[50] WL[49] WL[48] WL[47] WL[46] WL[45] WL[44]
+ WL[43] WL[42] WL[41] WL[40] WL[39] WL[38] WL[37] WL[36] WL[35] WL[34] WL[33] WL[32] WL[31] WL[30] WL[29] WL[28] WL[27] WL[26] WL[25]
+ WL[24] WL[23] WL[22] WL[21] WL[20] WL[19] WL[18] WL[17] WL[16] WL[15] WL[14] WL[13] WL[12] WL[11] WL[10] WL[9] WL[8] WL[7] WL[6] WL[5]
+ WL[4] WL[3] WL[2] WL[1] WL[0] DOUT[11] DOUTB[11] VDD VSS bit_slice
XS[10] PRE_B SEL0 SEL0B SEL1 SEL1B SAE WE DL[10] WL[127] WL[126] WL[125] WL[124] WL[123] WL[122] WL[121] WL[120] WL[119] WL[118]
+ WL[117] WL[116] WL[115] WL[114] WL[113] WL[112] WL[111] WL[110] WL[109] WL[108] WL[107] WL[106] WL[105] WL[104] WL[103] WL[102] WL[101]
+ WL[100] WL[99] WL[98] WL[97] WL[96] WL[95] WL[94] WL[93] WL[92] WL[91] WL[90] WL[89] WL[88] WL[87] WL[86] WL[85] WL[84] WL[83] WL[82]
+ WL[81] WL[80] WL[79] WL[78] WL[77] WL[76] WL[75] WL[74] WL[73] WL[72] WL[71] WL[70] WL[69] WL[68] WL[67] WL[66] WL[65] WL[64] WL[63]
+ WL[62] WL[61] WL[60] WL[59] WL[58] WL[57] WL[56] WL[55] WL[54] WL[53] WL[52] WL[51] WL[50] WL[49] WL[48] WL[47] WL[46] WL[45] WL[44]
+ WL[43] WL[42] WL[41] WL[40] WL[39] WL[38] WL[37] WL[36] WL[35] WL[34] WL[33] WL[32] WL[31] WL[30] WL[29] WL[28] WL[27] WL[26] WL[25]
+ WL[24] WL[23] WL[22] WL[21] WL[20] WL[19] WL[18] WL[17] WL[16] WL[15] WL[14] WL[13] WL[12] WL[11] WL[10] WL[9] WL[8] WL[7] WL[6] WL[5]
+ WL[4] WL[3] WL[2] WL[1] WL[0] DOUT[10] DOUTB[10] VDD VSS bit_slice
XS[9] PRE_B SEL0 SEL0B SEL1 SEL1B SAE WE DL[9] WL[127] WL[126] WL[125] WL[124] WL[123] WL[122] WL[121] WL[120] WL[119] WL[118]
+ WL[117] WL[116] WL[115] WL[114] WL[113] WL[112] WL[111] WL[110] WL[109] WL[108] WL[107] WL[106] WL[105] WL[104] WL[103] WL[102] WL[101]
+ WL[100] WL[99] WL[98] WL[97] WL[96] WL[95] WL[94] WL[93] WL[92] WL[91] WL[90] WL[89] WL[88] WL[87] WL[86] WL[85] WL[84] WL[83] WL[82]
+ WL[81] WL[80] WL[79] WL[78] WL[77] WL[76] WL[75] WL[74] WL[73] WL[72] WL[71] WL[70] WL[69] WL[68] WL[67] WL[66] WL[65] WL[64] WL[63]
+ WL[62] WL[61] WL[60] WL[59] WL[58] WL[57] WL[56] WL[55] WL[54] WL[53] WL[52] WL[51] WL[50] WL[49] WL[48] WL[47] WL[46] WL[45] WL[44]
+ WL[43] WL[42] WL[41] WL[40] WL[39] WL[38] WL[37] WL[36] WL[35] WL[34] WL[33] WL[32] WL[31] WL[30] WL[29] WL[28] WL[27] WL[26] WL[25]
+ WL[24] WL[23] WL[22] WL[21] WL[20] WL[19] WL[18] WL[17] WL[16] WL[15] WL[14] WL[13] WL[12] WL[11] WL[10] WL[9] WL[8] WL[7] WL[6] WL[5]
+ WL[4] WL[3] WL[2] WL[1] WL[0] DOUT[9] DOUTB[9] VDD VSS bit_slice
XS[8] PRE_B SEL0 SEL0B SEL1 SEL1B SAE WE DL[8] WL[127] WL[126] WL[125] WL[124] WL[123] WL[122] WL[121] WL[120] WL[119] WL[118]
+ WL[117] WL[116] WL[115] WL[114] WL[113] WL[112] WL[111] WL[110] WL[109] WL[108] WL[107] WL[106] WL[105] WL[104] WL[103] WL[102] WL[101]
+ WL[100] WL[99] WL[98] WL[97] WL[96] WL[95] WL[94] WL[93] WL[92] WL[91] WL[90] WL[89] WL[88] WL[87] WL[86] WL[85] WL[84] WL[83] WL[82]
+ WL[81] WL[80] WL[79] WL[78] WL[77] WL[76] WL[75] WL[74] WL[73] WL[72] WL[71] WL[70] WL[69] WL[68] WL[67] WL[66] WL[65] WL[64] WL[63]
+ WL[62] WL[61] WL[60] WL[59] WL[58] WL[57] WL[56] WL[55] WL[54] WL[53] WL[52] WL[51] WL[50] WL[49] WL[48] WL[47] WL[46] WL[45] WL[44]
+ WL[43] WL[42] WL[41] WL[40] WL[39] WL[38] WL[37] WL[36] WL[35] WL[34] WL[33] WL[32] WL[31] WL[30] WL[29] WL[28] WL[27] WL[26] WL[25]
+ WL[24] WL[23] WL[22] WL[21] WL[20] WL[19] WL[18] WL[17] WL[16] WL[15] WL[14] WL[13] WL[12] WL[11] WL[10] WL[9] WL[8] WL[7] WL[6] WL[5]
+ WL[4] WL[3] WL[2] WL[1] WL[0] DOUT[8] DOUTB[8] VDD VSS bit_slice
XS[7] PRE_B SEL0 SEL0B SEL1 SEL1B SAE WE DL[7] WL[127] WL[126] WL[125] WL[124] WL[123] WL[122] WL[121] WL[120] WL[119] WL[118]
+ WL[117] WL[116] WL[115] WL[114] WL[113] WL[112] WL[111] WL[110] WL[109] WL[108] WL[107] WL[106] WL[105] WL[104] WL[103] WL[102] WL[101]
+ WL[100] WL[99] WL[98] WL[97] WL[96] WL[95] WL[94] WL[93] WL[92] WL[91] WL[90] WL[89] WL[88] WL[87] WL[86] WL[85] WL[84] WL[83] WL[82]
+ WL[81] WL[80] WL[79] WL[78] WL[77] WL[76] WL[75] WL[74] WL[73] WL[72] WL[71] WL[70] WL[69] WL[68] WL[67] WL[66] WL[65] WL[64] WL[63]
+ WL[62] WL[61] WL[60] WL[59] WL[58] WL[57] WL[56] WL[55] WL[54] WL[53] WL[52] WL[51] WL[50] WL[49] WL[48] WL[47] WL[46] WL[45] WL[44]
+ WL[43] WL[42] WL[41] WL[40] WL[39] WL[38] WL[37] WL[36] WL[35] WL[34] WL[33] WL[32] WL[31] WL[30] WL[29] WL[28] WL[27] WL[26] WL[25]
+ WL[24] WL[23] WL[22] WL[21] WL[20] WL[19] WL[18] WL[17] WL[16] WL[15] WL[14] WL[13] WL[12] WL[11] WL[10] WL[9] WL[8] WL[7] WL[6] WL[5]
+ WL[4] WL[3] WL[2] WL[1] WL[0] DOUT[7] DOUTB[7] VDD VSS bit_slice
XS[6] PRE_B SEL0 SEL0B SEL1 SEL1B SAE WE DL[6] WL[127] WL[126] WL[125] WL[124] WL[123] WL[122] WL[121] WL[120] WL[119] WL[118]
+ WL[117] WL[116] WL[115] WL[114] WL[113] WL[112] WL[111] WL[110] WL[109] WL[108] WL[107] WL[106] WL[105] WL[104] WL[103] WL[102] WL[101]
+ WL[100] WL[99] WL[98] WL[97] WL[96] WL[95] WL[94] WL[93] WL[92] WL[91] WL[90] WL[89] WL[88] WL[87] WL[86] WL[85] WL[84] WL[83] WL[82]
+ WL[81] WL[80] WL[79] WL[78] WL[77] WL[76] WL[75] WL[74] WL[73] WL[72] WL[71] WL[70] WL[69] WL[68] WL[67] WL[66] WL[65] WL[64] WL[63]
+ WL[62] WL[61] WL[60] WL[59] WL[58] WL[57] WL[56] WL[55] WL[54] WL[53] WL[52] WL[51] WL[50] WL[49] WL[48] WL[47] WL[46] WL[45] WL[44]
+ WL[43] WL[42] WL[41] WL[40] WL[39] WL[38] WL[37] WL[36] WL[35] WL[34] WL[33] WL[32] WL[31] WL[30] WL[29] WL[28] WL[27] WL[26] WL[25]
+ WL[24] WL[23] WL[22] WL[21] WL[20] WL[19] WL[18] WL[17] WL[16] WL[15] WL[14] WL[13] WL[12] WL[11] WL[10] WL[9] WL[8] WL[7] WL[6] WL[5]
+ WL[4] WL[3] WL[2] WL[1] WL[0] DOUT[6] DOUTB[6] VDD VSS bit_slice
XS[5] PRE_B SEL0 SEL0B SEL1 SEL1B SAE WE DL[5] WL[127] WL[126] WL[125] WL[124] WL[123] WL[122] WL[121] WL[120] WL[119] WL[118]
+ WL[117] WL[116] WL[115] WL[114] WL[113] WL[112] WL[111] WL[110] WL[109] WL[108] WL[107] WL[106] WL[105] WL[104] WL[103] WL[102] WL[101]
+ WL[100] WL[99] WL[98] WL[97] WL[96] WL[95] WL[94] WL[93] WL[92] WL[91] WL[90] WL[89] WL[88] WL[87] WL[86] WL[85] WL[84] WL[83] WL[82]
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
