2AMLogic/sg13g2-sram/sim/array/bench_access.cir

* Access-time bench: clock edge to valid Q, and write completion (circuit body for `klt sim`;
* no .control/.end). GENERATED by `array_post.py gen-access` from the top-level instances of
* design/macro/macro.spice; run_array.sh fails if this file is stale.
*
* Representative macro: the real address latch, control, row decoder, data latch and out latch
* (full 32-bit banks), and the real bit slice 0 (2 bit-line pairs x 128 cells, precharge, mux,
* sense amp, write driver) at the selected address. The other 31 I/O are represented by their
* load only: 31 dummy slices (2 precharge, mux, sense amp, write driver on private bit lines)
* on PRE_B / SEL* / SAE / WE / DL[k] / DOUT[k], and 62 bitcells (their access gates) on the selected
* wordline WL[45]. Wordlines of other rows are not loaded: they do not switch at this address.
* Schematic level: no wire parasitics.
*
* Address 0x5A: A[7:1] = 45 selects WL[45], A[0] = 0 selects column 0 (SEL0 high).
* Six cycles, 8 ns period, CLK high 3 ns (rising 50 % at 4.05, 12.05, 20.05, 28.05, 36.05, 44.05 ns):
*   write 1, read (expects 1), write 0, read (expects 0), write 1, read (expects 1).
* The first read only puts a 1 into the output latch; the last read follows a read of 0, so its Q rise is
* a clean transition. CEN low, GWEN = WEN low in the write cycles; address, data and controls change in the
* CLK-low phase (latches transparent), 3 ns before each edge. Every cell starts holding 0 (.ic).
* All levels scale with VDD (request supply corner).
.include ../../design/macro/macro.spice

Vdd vdd 0 DC 1.2
* the macro's VSS port is a net named VSS, not node 0
Vvss VSS 0 DC 0
* thresholds that follow the supply corner
Bthr9 thr9 0 V = 0.9*v(vdd)
Bthr5 thr5 0 V = 0.5*v(vdd)
Bthr1 thr1 0 V = 0.1*v(vdd)
* clock: unit pulse x VDD
Vpclk pclk 0 PULSE(0 1 4n 100p 100p 3n 8n)
Bclk CLK 0 V = v(pclk)*v(vdd)
Bclkm clkm 0 V = v(CLK)
Bcen CEN 0 V = 0
* GWEN = WEN: low (write) in cycles 1 and 3, high (read) in cycles 2 and 4
Vpgw pgw 0 PWL(0 0 9n 0 9.1n 1 17n 1 17.1n 0 25n 0 25.1n 1 33n 1 33.1n 0 41n 0 41.1n 1 57n 1)
Bgwen GWEN 0 V = v(pgw)*v(vdd)
Bwen  WEN  0 V = v(pgw)*v(vdd)
* D[0]: 1 for the first write, 0 for the second
Vpd0 pd0 0 PWL(0 1 17n 1 17.1n 0 25n 0 25.1n 1 57n 1)
Bd0 D[0] 0 V = v(pd0)*v(vdd)
Bd1 D[1] 0 V = 0
Bd2 D[2] 0 V = 0
Bd3 D[3] 0 V = 0
Bd4 D[4] 0 V = 0
Bd5 D[5] 0 V = 0
Bd6 D[6] 0 V = 0
Bd7 D[7] 0 V = 0
Bd8 D[8] 0 V = 0
Bd9 D[9] 0 V = 0
Bd10 D[10] 0 V = 0
Bd11 D[11] 0 V = 0
Bd12 D[12] 0 V = 0
Bd13 D[13] 0 V = 0
Bd14 D[14] 0 V = 0
Bd15 D[15] 0 V = 0
Bd16 D[16] 0 V = 0
Bd17 D[17] 0 V = 0
Bd18 D[18] 0 V = 0
Bd19 D[19] 0 V = 0
Bd20 D[20] 0 V = 0
Bd21 D[21] 0 V = 0
Bd22 D[22] 0 V = 0
Bd23 D[23] 0 V = 0
Bd24 D[24] 0 V = 0
Bd25 D[25] 0 V = 0
Bd26 D[26] 0 V = 0
Bd27 D[27] 0 V = 0
Bd28 D[28] 0 V = 0
Bd29 D[29] 0 V = 0
Bd30 D[30] 0 V = 0
Bd31 D[31] 0 V = 0
Ba0 A[0] 0 V = 0
Ba1 A[1] 0 V = v(vdd)
Ba2 A[2] 0 V = 0
Ba3 A[3] 0 V = v(vdd)
Ba4 A[4] 0 V = v(vdd)
Ba5 A[5] 0 V = 0
Ba6 A[6] 0 V = v(vdd)
Ba7 A[7] 0 V = 0

* the macro, minus slices 1..31 (replaced by load below)
XAL CLK A[7] A[6] A[5] A[4] A[3] A[2] A[1] A[0] CEN GWEN WEN AL[7] AL[6] AL[5] AL[4] AL[3] AL[2] AL[1] AL[0] CENL GWENL WENL VDD
+ VSS addr_latch
XCTL CLK CENL GWENL WENL AL[0] PRE_B WLEN SAE WE SEL0 SEL0B SEL1 SEL1B VDD VSS control
XDEC AL[7] AL[6] AL[5] AL[4] AL[3] AL[2] AL[1] WLEN WL[127] WL[126] WL[125] WL[124] WL[123] WL[122] WL[121] WL[120] WL[119]
+ WL[118] WL[117] WL[116] WL[115] WL[114] WL[113] WL[112] WL[111] WL[110] WL[109] WL[108] WL[107] WL[106] WL[105] WL[104] WL[103]
+ WL[102] WL[101] WL[100] WL[99] WL[98] WL[97] WL[96] WL[95] WL[94] WL[93] WL[92] WL[91] WL[90] WL[89] WL[88] WL[87] WL[86] WL[85]
+ WL[84] WL[83] WL[82] WL[81] WL[80] WL[79] WL[78] WL[77] WL[76] WL[75] WL[74] WL[73] WL[72] WL[71] WL[70] WL[69] WL[68] WL[67]
+ WL[66] WL[65] WL[64] WL[63] WL[62] WL[61] WL[60] WL[59] WL[58] WL[57] WL[56] WL[55] WL[54] WL[53] WL[52] WL[51] WL[50] WL[49]
+ WL[48] WL[47] WL[46] WL[45] WL[44] WL[43] WL[42] WL[41] WL[40] WL[39] WL[38] WL[37] WL[36] WL[35] WL[34] WL[33] WL[32] WL[31]
+ WL[30] WL[29] WL[28] WL[27] WL[26] WL[25] WL[24] WL[23] WL[22] WL[21] WL[20] WL[19] WL[18] WL[17] WL[16] WL[15] WL[14] WL[13]
+ WL[12] WL[11] WL[10] WL[9] WL[8] WL[7] WL[6] WL[5] WL[4] WL[3] WL[2] WL[1] WL[0] VDD VSS row_decoder
XDL CLK D[31] D[30] D[29] D[28] D[27] D[26] D[25] D[24] D[23] D[22] D[21] D[20] D[19] D[18] D[17] D[16] D[15] D[14] D[13] D[12]
+ D[11] D[10] D[9] D[8] D[7] D[6] D[5] D[4] D[3] D[2] D[1] D[0] DL[31] DL[30] DL[29] DL[28] DL[27] DL[26] DL[25] DL[24] DL[23]
+ DL[22] DL[21] DL[20] DL[19] DL[18] DL[17] DL[16] DL[15] DL[14] DL[13] DL[12] DL[11] DL[10] DL[9] DL[8] DL[7] DL[6] DL[5] DL[4]
+ DL[3] DL[2] DL[1] DL[0] VDD VSS data_latch
XS[0] PRE_B SEL0 SEL0B SEL1 SEL1B SAE WE DL[0] WL[127] WL[126] WL[125] WL[124] WL[123] WL[122] WL[121] WL[120] WL[119] WL[118]
+ WL[117] WL[116] WL[115] WL[114] WL[113] WL[112] WL[111] WL[110] WL[109] WL[108] WL[107] WL[106] WL[105] WL[104] WL[103] WL[102]
+ WL[101] WL[100] WL[99] WL[98] WL[97] WL[96] WL[95] WL[94] WL[93] WL[92] WL[91] WL[90] WL[89] WL[88] WL[87] WL[86] WL[85] WL[84]
+ WL[83] WL[82] WL[81] WL[80] WL[79] WL[78] WL[77] WL[76] WL[75] WL[74] WL[73] WL[72] WL[71] WL[70] WL[69] WL[68] WL[67] WL[66]
+ WL[65] WL[64] WL[63] WL[62] WL[61] WL[60] WL[59] WL[58] WL[57] WL[56] WL[55] WL[54] WL[53] WL[52] WL[51] WL[50] WL[49] WL[48]
+ WL[47] WL[46] WL[45] WL[44] WL[43] WL[42] WL[41] WL[40] WL[39] WL[38] WL[37] WL[36] WL[35] WL[34] WL[33] WL[32] WL[31] WL[30]
+ WL[29] WL[28] WL[27] WL[26] WL[25] WL[24] WL[23] WL[22] WL[21] WL[20] WL[19] WL[18] WL[17] WL[16] WL[15] WL[14] WL[13] WL[12]
+ WL[11] WL[10] WL[9] WL[8] WL[7] WL[6] WL[5] WL[4] WL[3] WL[2] WL[1] WL[0] DOUT[0] DOUTB[0] VDD VSS bit_slice
XQL SAE DOUT[31] DOUT[30] DOUT[29] DOUT[28] DOUT[27] DOUT[26] DOUT[25] DOUT[24] DOUT[23] DOUT[22] DOUT[21] DOUT[20] DOUT[19]
+ DOUT[18] DOUT[17] DOUT[16] DOUT[15] DOUT[14] DOUT[13] DOUT[12] DOUT[11] DOUT[10] DOUT[9] DOUT[8] DOUT[7] DOUT[6] DOUT[5] DOUT[4]
+ DOUT[3] DOUT[2] DOUT[1] DOUT[0] Q[31] Q[30] Q[29] Q[28] Q[27] Q[26] Q[25] Q[24] Q[23] Q[22] Q[21] Q[20] Q[19] Q[18] Q[17] Q[16]
+ Q[15] Q[14] Q[13] Q[12] Q[11] Q[10] Q[9] Q[8] Q[7] Q[6] Q[5] Q[4] Q[3] Q[2] Q[1] Q[0] VDD VSS out_latch

* dummy wordline load: the access gates of the other 62 cells on the selected row
Xwl0 vdd vdd WL[45] vdd 0 dq0 dqb0 bitcell
Xwl1 vdd vdd WL[45] vdd 0 dq1 dqb1 bitcell
Xwl2 vdd vdd WL[45] vdd 0 dq2 dqb2 bitcell
Xwl3 vdd vdd WL[45] vdd 0 dq3 dqb3 bitcell
Xwl4 vdd vdd WL[45] vdd 0 dq4 dqb4 bitcell
Xwl5 vdd vdd WL[45] vdd 0 dq5 dqb5 bitcell
Xwl6 vdd vdd WL[45] vdd 0 dq6 dqb6 bitcell
Xwl7 vdd vdd WL[45] vdd 0 dq7 dqb7 bitcell
Xwl8 vdd vdd WL[45] vdd 0 dq8 dqb8 bitcell
Xwl9 vdd vdd WL[45] vdd 0 dq9 dqb9 bitcell
Xwl10 vdd vdd WL[45] vdd 0 dq10 dqb10 bitcell
Xwl11 vdd vdd WL[45] vdd 0 dq11 dqb11 bitcell
Xwl12 vdd vdd WL[45] vdd 0 dq12 dqb12 bitcell
Xwl13 vdd vdd WL[45] vdd 0 dq13 dqb13 bitcell
Xwl14 vdd vdd WL[45] vdd 0 dq14 dqb14 bitcell
Xwl15 vdd vdd WL[45] vdd 0 dq15 dqb15 bitcell
Xwl16 vdd vdd WL[45] vdd 0 dq16 dqb16 bitcell
Xwl17 vdd vdd WL[45] vdd 0 dq17 dqb17 bitcell
Xwl18 vdd vdd WL[45] vdd 0 dq18 dqb18 bitcell
Xwl19 vdd vdd WL[45] vdd 0 dq19 dqb19 bitcell
Xwl20 vdd vdd WL[45] vdd 0 dq20 dqb20 bitcell
Xwl21 vdd vdd WL[45] vdd 0 dq21 dqb21 bitcell
Xwl22 vdd vdd WL[45] vdd 0 dq22 dqb22 bitcell
Xwl23 vdd vdd WL[45] vdd 0 dq23 dqb23 bitcell
Xwl24 vdd vdd WL[45] vdd 0 dq24 dqb24 bitcell
Xwl25 vdd vdd WL[45] vdd 0 dq25 dqb25 bitcell
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
Xfp1_30 PRE_B fb1_30 fbb1_30 vdd 0 precharge
Xfm_30 SEL0 SEL0B SEL1 SEL1B fb0_30 fbb0_30 fb1_30 fbb1_30 fbm_30 fbbm_30 vdd 0 column_mux
Xfs_30 SAE fbm_30 fbbm_30 DOUT[30] fdoutb_30 vdd 0 sense_amp
Xfw_30 WE DL[30] fbm_30 fbbm_30 vdd 0 write_driver
Xfp0_31 PRE_B fb0_31 fbb0_31 vdd 0 precharge
Xfp1_31 PRE_B fb1_31 fbb1_31 vdd 0 precharge
Xfm_31 SEL0 SEL0B SEL1 SEL1B fb0_31 fbb0_31 fb1_31 fbb1_31 fbm_31 fbbm_31 vdd 0 column_mux
Xfs_31 SAE fbm_31 fbbm_31 DOUT[31] fdoutb_31 vdd 0 sense_amp
Xfw_31 WE DL[31] fbm_31 fbbm_31 vdd 0 write_driver
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
