2AMLogic/sg13g2-sram/sim/pdk-smoke/records/20261017T220236Z/netlists/sg13_hv_nmos.cir

* sg13_hv_nmos smoke: DC op + Id-Vgs, mos_tt, 27 C. Toolchain check only, not a spec bias.
.lib "${PDK_ROOT}/ihp-sg13g2/libs.tech/ngspice/models/cornerMOShv.lib" mos_tt
.temp 27
Vd d 0 dc 1.65
Vg g 0 dc 1.65
XM d g 0 0 sg13_hv_nmos w=1u l=0.45u ng=1 m=1
.control
pre_osdi ${PDK_ROOT}/ihp-sg13g2/libs.tech/ngspice/osdi/psp103.osdi
pre_osdi ${PDK_ROOT}/ihp-sg13g2/libs.tech/ngspice/osdi/psp103_nqs.osdi
pre_osdi ${PDK_ROOT}/ihp-sg13g2/libs.tech/ngspice/osdi/r3_cmc.osdi
pre_osdi ${PDK_ROOT}/ihp-sg13g2/libs.tech/ngspice/osdi/mosvar.osdi
op
print i(Vd)
dc Vg 0 3.3 0.09999999999999999
wrdata /tmp/tmp.zgbEge5Lw0/sg13_hv_nmos.sweep.txt i(Vd)
.endc
.end
