2AMLogic/sg13g2-sram/(commit log)

2026-10-17 Initial commit: sg13g2-sram canary block
    Seeds the canary admitted under 2AMLogic/2am#5101 (the IP block x open PDK
    matrix): README with the block's targets, CLAUDE.md with the agent rules
    and friction protocol, and the empty flow directories. Nothing designed yet.
2026-10-17 chore(loom): Install Loom 0.19.1181 orchestration framework
    Adds Loom configuration and workflow integration:
    - .loom/ directory with configuration and scripts
    - .claude/commands/loom/ slash commands for roles (/loom/builder, /loom/judge, etc.)
    - .claude/settings.json tool permissions
    - .github/ labels and workflows
    - Documentation (CLAUDE.md)
    Loom Version: 0.19.1181
    Loom Commit: 9f0fa9553
    Skip-CI-Hint: docs-only
2026-10-17 feat(sim): pin IHP-Open-PDK, vendor OSDI build, add four-device smoke record
2026-10-23 feat: 6T bitcell schematic and hold/read SNM + write-margin characterization over 45 corners
    Adds the reference-sizing bitcell (xschem + klt netlist), batch-fleet benches,
    a run script with a beta-0.25 negative control, and the first append-only record.
    SNM is the inscribed square; snm_extract.py's vertical-gap value is kept beside it.
2026-10-27 docs: README spec table and reproduction steps, item 10 attestation, klt 0.8.0
    Bump the klt pin to 0.8.0 and re-vendor the tiers doc, refresh the README
    status/layout, mirror the spec table with an npm-test check, add the
    reproduction section, and attest T1 item 10 via klt signoff --attest.
2026-10-27 feat: column schematics, derived netlists and nominal bench (unsimulated)
    Add precharge, 2:1 column mux, latch sense amp, write driver and a column
    schematic tiling the bitcell 128 per bit line, with symbols, derived netlists,
    design/netlist.sh (regenerate/--check), and a nominal read/write bench with
    post-processing, negative controls and unit tests. The bench has not run:
    the batch fleet refused every available client version.
2026-10-27 docs: install two-key ratification keys and open post-hoc review record
    Adds ratification/ee-key and ratification/market-key adapted from
    gf180-gate-driver for an SRAM macro, and a decision record for the
    post-hoc review of spec/sram.md. Neither key has been run: both need
    non-author identities.
    Part of #37
2026-10-27 feat: run the column bench on the batch fleet and record the nominal result
    Netlist generation runs from the schematic directory so relative symbol paths
    resolve, and two long schematic comments are shortened so the committed netlists
    do not depend on the xschem version's comment wrapping. The bench record shows
    read and write working and the unselected-column bit-line check failing.
2026-10-28 feat: batch-set write-driver width sweep and sizing summary for the column
    run_sizing.sh builds one write bench per driver-stack width and submits them
    as a single klt sim batch-set; column_post.py sizing summarises flip time and
    the smallest passing width. The sweep has not run: the fleet refused every
    request for capacity.
2026-10-28 feat: record write-driver width sweep and justify the column's driver sizing
    Ran the six-width sweep on the batch fleet (nominal mos_tt/1.20 V/27 C).
    run_sizing.sh now keeps the per-width reports and writes summary.json
    instead of leaving them in a deleted scratch dir.
2026-10-28 feat: add decoder, control, latch and macro-top schematics with item 1 attestation
2026-10-28 ci: check the item 1 attestation for drift and pin it in the manifest
2026-10-28 feat: add array-level benches, testbench inventory and item 9 attestation
    In-situ read SNM, write margin through the real driver, and access time /
    write completion over the 45 corners on the batch fleet, with negative
    controls and unit-tested extractors; sim/run_all.sh cold start; item 9
    envelope cited in the manifest (item 9 reads met); CI drift check.
    Closes #26
2026-10-28 refactor: share one run_klt helper across the sim run scripts
    Folds the three diverging run_klt copies and the duplicated S3 bucket
    redaction into sim/harness/common/run_klt.sh with an explicit
    tolerate_exit4 argument, preserving each script's current exit-4
    behaviour. Adds the helper to the item 9 inventory and refreshes its
    envelope.
2026-10-29 docs(spec): propose physical organization and a wire-RC check for the wordline and bit lines
2026-10-30 feat: add SG13G2 macro layout generator, GDS, LEF and item 2 attestation
    Tiles the 6T bitcell 128 x 64 (8192 instances) with mirror abutment,
    builds the periphery subcircuits as placed, labelled transistors at the
    netlist W/L, and emits macro.gds, a socket descriptor and a klt
    lef-abstract LEF with the full pin set. Periphery and array-to-column
    routing are not drawn; recorded in layout/README.md.
2026-10-30 fix: clear macro NWell spacing and add full-array DRC evidence for T1 item 3
    The first klt drc of the macro found 522 nwell.space.1 violations from
    periphery PMOS wells packed 0.5 um apart (NW.b is 0.62 um). Raise PACK_GAP to
    0.65 um, regenerate the GDS/LEF/socket/record and the item 2 envelope, commit
    the clean drc-macro.json (coverage gaps quoted in layout/README.md), and cite it
    for item 3.
2026-10-30 feat: add per-device body ties to the macro periphery and mint a taps record
    Each periphery transistor gets a body tie labelled with its netlist bulk
    net; klt extract recognises all 51,948 netlist devices. The #87 record is
    left untouched; the new result is layout/reports/macro-record-taps.json.
2026-10-30 feat: route macro wordlines and bit lines between the array and the periphery
    Wordline r: GatPoly landing pad, Cont, Metal1, Via1, Metal2/3 to the
    wl_driver output through private Metal3 tracks and Metal2 lanes in a widened
    decoder-to-array gap. Bit lines: Via1/Via2 stack under each Metal1 stripe,
    a Metal3 lane at the stripe's x and Metal2 jogs to one BL/BLB terminal of the
    precharge and of the column mux. Terminal coordinates come from the
    generator's placement record. Adds net-tracing tests with teeth and the
    routed-macro record; macro-record.json is untouched.
2026-10-30 feat: wire periphery body ties and bitcell risers to VDD/VSS rails
    Via1 + Metal2 pad on every periphery tie, Metal2 stubs to Metal3 lanes per
    floorplan region, lanes to two Metal4 trunks; Metal1 pad + Via1 + Metal2 strap
    at every array row seam to the same trunks. Adds a flat rail-connectivity
    analysis (rails_check.py), tests with a removed-via negative case, the
    macro-record-rails.json evidence record, and verify.sh step 8.
2026-10-30 feat: net-aware Metal2/Metal3 router, flat-net resolution and leaf-cell signal nets
    Add MazeRouter (two-layer maze on a 0.05 um lattice, M2.b/M3.b/V2.b kept
    between nets) and flat_nets (hierarchical nets of macro.spice resolved per
    instance path, supply/bit-line/wordline flagged). Draw every intra-cell net of
    inv, inv_x4, dlatch, nand2/3/4, nor2, precharge, column_mux, sense_amp and
    write_driver; column_mux BLBM is listed as undrawn. Body-tie stubs gain a
    Metal3 and a maze fallback where the cell nets take the Metal2, nothing enters
    the wordline gap, and the D/Q pins move 0.21 um further out. New record
    macro-record-leafnets.json (the rails record's hashes no longer match the
    regenerated lay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
2026-10-30 fix: re-attest items 2 and 3 against the regenerated macro.gds
    Refresh attest/item2.envelope.json, re-pin the manifest content_hash for items 2
    and 3 to the new GDS, and regenerate the graded signoff record (klt 0.8.0).
    t1_met_count is back to 5.
2026-10-30 feat: route the nets between leaf cells of the latch and control cells
    Add route_hier: the nets joining the leaf cells of addr_latch, data_latch,
    out_latch and control (27 nets, supply excluded) are drawn with MazeRouter on
    Metal2/Metal3, treating the leaf cells' own shapes as obstacles except those
    of the net being joined. Nets of many terminals use a directed A* search, and
    the leaf cells are packed on the router lattice HIER_PACK_GAP apart. Adds
    connectivity tests with teeth, a new evidence record and refreshed macro
    GDS/LEF/socket and macro DRC report (clean).
2026-10-30 fix: re-attest item 2 and regenerate the signoff record for the new macro.gds
    Refresh attest/item2.envelope.json (klt ce6583fe, as before), re-pin the item 2 and 3
    content_hash in the manifest, and regenerate the graded record with klt 0.8.0.
    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
2026-10-31 feat: route the decoder nets on main's router (predec3, predec4, wl_drivers, row_decoder)
    Re-express PR #116's decoder routing on the leaf-cell router that main has
    (connect_to / search_routes / leaf_shapes): route_hier now also joins the nets
    between the children of the four decoder cells, a hierarchically routed cell
    hands its drawn shapes, ties, Via2s and landings to the cell above (export_hier),
    and one HIER_ROUTED covers all eight cells. connect_astar is dropped: connect_to
    routes every decoder net (87, none undrawn) without it.
    Also ported from #116, as the decoder cells change what the rails and wordlines
    meet: wl_driver as a routed leaf with the wordline stub/track band reserved
    (wl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
2026-11-01 docs(spec): add hrhc interconnect-C case, say Proposed not ratified (#82 review)
    - Row 3: ihp-sg13g2-extract.tech states max/min capacitance corners
    (hrhc/lrhc/hrlc/lrlc); add High-end R and C (hrhc) axis row and correct
    the 'no capacitance corner found' claim.
    - Row 4: the spec/sram.md write-margin requirement is Proposed, not ratified.
2026-11-01 docs: correct access-time record's crossings, pin and evidence state (PR #85 review)
    - State the bench's graded crossings (CLK 50% -> Q[0] 90%/10%) and name Q[0]
    - Cite the two committed access records and the real slowest corner
    - Describe the comp arc as the A_DOUT[31:0] bus arc
2026-11-06 chore: remove superseded per-stage macro-record scripts
    Delete the routed, rails, leafnets and latchnets minting scripts; each
    rebuilt the current layout then wrote an older-stage record. Repoint the
    layout README at generate-macro-decoder.sh and add git-show recovery hints.
2026-11-14 feat(attest): add pinned mint script for item 10 attestation envelope
    Re-signing a staled `attest/*.envelope.json` had no written-down command, and
    the reflex one is wrong: the host `klt` is an unreleased build newer than CI's
    `KLT_VERSION` pin, and its `--format json > …` form emits a `manifest_entry`
    block the pinned `--check` rejects (rc=3).
    `attest/mint.sh` reads the pin from `.github/workflows/ci.yml` rather than
    adding a seventh hardcoded copy, and mints through
    `uvx --from "klayout-tools==$PIN"` with `-o` into a temp file before `mv`.
    Item 10 is the only item mintable at the pin: items 1 and 9 have 25 and 1
    `local_only: true` inventory entries (PDK freshness commands; a 6-hour flee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
